parkourlrc/pcb-PionixPublic--cb-eval-board-5fd87b56d0/cb-eval-board/production/1.2/CB-EVAL-1.2-gerber/README.txt

PCB specs:

4 Layers (from Top to bottom):

1. cb-eval-board-F: Top
2. cb-eval-board-GND: 
3. cb-eval-board-VCC
4. cb-eval-board-B: Bottom

Thickness: 1.6mm
Size: 120x108mm
Material: FR4
Copper: 35um (inner and outer layers)
Finish: chem Gold
IPC-A-600 class 2

Silkscreen: both sides
----------------------
Top: F_Silkscreen
Bottom: B_Silkscreen
Silkscreen Color: White

Solder Mask:
------------
Top: F_Mask
Bottom: B_Mask
Color: Black

- Edge Cuts are on a separate layer:
  cb-eval-board-Edge_Cuts

Minimum trace size: 0.15mm
Minimum clearance: 0.15mm
Minimal ring: 0.175mm
Via minimal hole size: 0.25mm
Via total diameter: 0.6mm
