parkourlrc/pcb-PionixPublic--cb-eval-board-5fd87b56d0/cb-eval-board/production/1.2/CB-EVAL-1.2-picknplace/cb-eval-bottomview.png

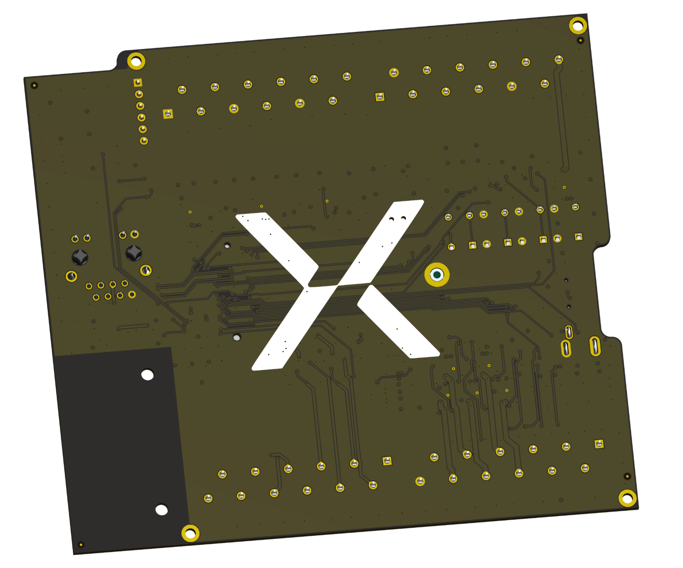
cb-eval-board/production/1.2/CB-EVAL-1.2-picknplace/cb-eval-bottomview.png
