parkourlrc/pcb-PionixPublic--cb-eval-board-5fd87b56d0/cb-eval-board/bom-devkit.csv

Reference | Value | Footprint | Qty | DNP | Manufacturer | MPN | Mouser | Digikey
C1,C2,C3,C9,C11,C12,C13,C14,C15,C21,C25,C26,C30,C31,C34,C36,C37,C39,C42,C45 | 100n | Capacitor_SMD:C_0603_1608Metric | 20 |  | Kemet | C0603C104K5RACAUTO |  | 399-6856-1-ND
C4,C7,C22,C23,C32,C43,C44 | 1u | Capacitor_SMD:C_0603_1608Metric | 7 |  | Kemet | C0603C105K3PACTU |  | 399-C0603C105K3PACTUCT-ND
C5,C6 | 4.7u 50V | Capacitor_SMD:C_1210_3225Metric | 2 |  | TDK Corporation | C3225X7R1H475K250AB |  | 445-7726-1-ND
C8 | 10u | Capacitor_SMD:C_0603_1608Metric | 1 |  | Murata Electronics | GRM188R6YA106MA73J |  | 490-GRM188R6YA106MA73JCT-ND
C10 | 100u 6.3V | Capacitor_SMD:C_1206_3216Metric | 1 |  | Taiyo Yuden | JMK316ABJ107ML-T |  | 587-3395-1-ND
C20,C24,C27,C33,C35,C40,C41 | 1n | Capacitor_SMD:C_0603_1608Metric | 7 |  | Kemet | C0603C102K5RACTU |  | 399-C0603C102K5RACTUCT-ND
C28,C29 | 100p | Capacitor_SMD:C_0603_1608Metric | 2 |  | Walsin Technology Corporation | 0603N101J500CT |  | 1292-1644-1-ND
D1,D4,D5,D6,D11,D12,D17,D18,D19,D21,D23,D25,D27,D29,D31,D33,D35,D37,D39 | LED YELLOW | LED_SMD:LED_0603_1608Metric | 19 |  | Würth Elektronik | 150060AS75000 |  | 732-150060AS75000CT-ND
D8 | CLV1L-FKB | cb-eval-lib:LED_Cree-PLCC4_3.2x2.8mm_CCW | 1 |  | Cree LED | CLV1L-FKB-CJQRNQEFGBB79353 |  | 90-CLV1L-FKB-CJQRNQEFGBB79353CT-ND
D9,D10 | MM3Z3V3ST1G | Diode_SMD:D_SOD-323 | 2 |  | onsemi | MM3Z3V3ST1G |  | MM3Z3V3ST1GOSCT-ND
D20,D22,D24,D26,D28,D30,D32,D34,D36,D38 | MM3Z5V1ST1G | Diode_SMD:D_SOD-323 | 10 |  | onsemi | MM3Z5V1ST1G |  | MM3Z5V1ST1GOSCT-ND
D41 | 5Vdc | cb-eval-lib:WE-TVS_SOT143-4L | 1 |  | Eaton - Electronics Division | STS142050UL08 |  | 283-STS142050UL08CT-ND
FB1,FB2,FB3 | 1.8k@100MHz | Inductor_SMD:L_0603_1608Metric | 3 |  | Wurth Elektronik | 742792692 |  | 732-4671-1-ND
H7 | Standoff_M.2 | cb-eval-lib:9774067243R | 1 |  | Würth Elektronik | 9774067243R
J1,J6 | Conn_01x01 | cb-eval-lib:2060451998404 | 2 |  | Wago | 2060-451/998-404 |  | 2946-2060-451/998-404CT-ND
J2 | Conn_01x06 | Connector_PinHeader_2.54mm:PinHeader_1x06_P2.54mm_Vertical | 1 |  | Samtec Inc. | TS-106-T-A |  | SAM1112-06-ND
J3 | I3C | Connector_PinHeader_2.54mm:PinHeader_1x02_P2.54mm_Vertical | 1 | Nicht bestücken | NONE | DNP
J4,J5,J7,J11 | TBL002A-350-12GY-2GY | cb-eval-lib:CUI_TBL002A-350-12GY-2GY | 4 |  | Same Sky (Formerly CUI Devices) | TBL002A-350-12GY-2GY |  | 102-6375-ND
J9 | USB_C_Receptacle_USB2.0_14P | cb-eval-lib:USB_C_Receptacle_GCT_USB4110 | 1 |  | GCT | USB4110-GF-A |  | 2073-USB4110-GF-A-1-ND
J10 | Barrel_Jack_Switch | cb-eval-lib:CUI_PJ-044AH | 1 |  | Same Sky (Formerly CUI Devices) | PJ-044AH |  | CP-044AH-ND
R1,R2,R3,R7,R13,R15,R17,R18,R19,R20,R21,R22,R23,R24,R27,R28,R31,R36,R37,R38,R39,R41,R42,R44,R45,R47,R48,R50,R51,R53,R54,R57,R59,R61,R75,R77 | 470 | Resistor_SMD:R_0603_1608Metric | 36 |  | Stackpole Electronics Inc | RMCF0603FT470R |  | RMCF0603FT470RCT-ND
R4,R5,R6,R10,R11,R69,R79,R80,R81,R82 | 330 | Resistor_SMD:R_0603_1608Metric | 10 |  | Stackpole Electronics Inc | RMCF0603FT330R |  | RMCF0603FT330RCT-ND
R8,R9,R25,R66,R88,R93,R105,R107,R109,R111,R113,R115,R117,R119 | 100k | Resistor_SMD:R_0603_1608Metric | 14 |  | Stackpole Electronics Inc | RMCF0603FT100K |  | RMCF0603FT100KCT-ND
R12 | 68 | Resistor_SMD:R_0603_1608Metric | 1 |  | Stackpole Electronics Inc | RMCF0603FT68R0 |  | RMCF0603FT68R0CT-ND
R14,R16 | 120 | Resistor_SMD:R_0603_1608Metric | 2 |  | Stackpole Electronics Inc | RMCF0603FT120R |  | RMCF0603FT120RCT-ND
R26,R33 | 5.6k | Resistor_SMD:R_0603_1608Metric | 2 |  | Stackpole Electronics Inc | RMCF0603FT5K60 |  | RMCF0603FT5K60CT-ND
R29,R83 | 6M 0.5% | Resistor_SMD:R_1206_3216Metric | 2 |  | Vishay Techno | CRMA1206AF6M00DKEF |  | 3579-CRMA1206AF6M00DKEFCT-ND
R30 | 20k 0.1% | Resistor_SMD:R_0603_1608Metric | 1 |  | Panasonic Electronic Components | ERA-3AEB203V |  | P20KDBCT-ND
R32 | 10k | Resistor_SMD:R_0603_1608Metric | 1 |  | Stackpole Electronics Inc | RMCF0603FT10K0 |  | RMCF0603FT10K0CT-ND
R34 | 402k | Resistor_SMD:R_0603_1608Metric | 1 |  | Stackpole Electronics Inc | RMCF0603FT402K
R35 | 137k | Resistor_SMD:R_0603_1608Metric | 1 |  | Stackpole Electronics Inc | RMCF0603FT137k
R40,R43,R46,R49,R52,R55,R68,R71,R74,R99 | 20k | Resistor_SMD:R_0603_1608Metric | 10 |  | Stackpole Electronics Inc | RMCF0603FT20K0 |  | RMCF0603FT20K0CT-ND
R56,R58,R60,R62,R64,R65,R67,R104,R106,R108,R110,R112,R114,R116,R118 | 1k | Resistor_SMD:R_0603_1608Metric | 15 |  | Stackpole Electronics Inc | RMCF0603FG1K00 |  | RMCF0603FG1K00CT-ND
R63 | 50m | Resistor_SMD:R_1206_3216Metric | 1 |  | Stackpole Electronics Inc | CSR1206FT50L0 |  | CSR1206FT50L0CT-ND
R70,R72,R84,R86,R89,R91 | 4.99k 0.1% | Resistor_SMD:R_0603_1608Metric | 6 |  | Panasonic Electronic Components | ERA-3AEB4991V |  | P4.99KDBCT-ND
R73,R76,R78,R94,R95,R96,R97,R98,R102,R103 | 1M | Resistor_SMD:R_0603_1608Metric | 10 |  | Stackpole Electronics Inc | RMCF0603FT1M00 |  | RMCF0603FT1M00CT-ND
R85,R90 | 825 0.1% | Resistor_SMD:R_0603_1608Metric | 2 |  | Panasonic Electronic Components | ERA-3AEB8250V |  | P909DBCT-ND
R87,R92 | 3.44k 0.1% | Resistor_SMD:R_0603_1608Metric | 2 |  | Panasonic Electronic Components | RN73R1JTTD3441B25 |  | P8.2KDBCT-ND
R100,R101 | 5.1k | Resistor_SMD:R_0603_1608Metric | 2 |  | Stackpole Electronics Inc | RMCF0603FT5K10 |  | RMCF0603FT5K10CT-ND
R120 | 0 | Resistor_SMD:R_0603_1608Metric | 1 |  | Stackpole Electronics Inc | RMCF0603ZT0R00 |  | RMCF0603ZT0R00CT-ND
SW1,SW2,SW3,SW4 | SW_Push | cb-eval-lib:SW_TS02-66-70-BK-160-LCR-D | 4 |  | Same Sky (Formerly CUI Devices) | TS02-66-70-BK-160-LCR-D |  | 2223-TS02-66-70-BK-160-LCR-D-ND
T1 | 74990101241 | cb-eval-lib:74990101241 | 1 |  | Wurth Elektronik | 74990101241 |  | 732-10834-ND
U1 | 10128796-001RLF | cb-eval-lib:AMPHENOL_10128796-001RLF_ChargeBridge_Wurth_standoff | 1 |  | Amphenol ICC (FCI) | 10128796-001RLF
U2,U3,U4,U25,U26,U27,U28,U29,U30,U31,U32,U33,U34 | 74LVC1G17 | Package_TO_SOT_SMD:SOT-353_SC-70-5 | 13 |  | Texas Instruments | SN74LVC1G17DCKR |  | 296-11934-1-ND
U5 | TMP100 | Package_TO_SOT_SMD:SOT-23-6 | 1 |  | Texas Instruments | TMP100NA/3K |  | 296-26833-1-ND
U6 | AMC3311DWER | cb-eval-lib:SOIC16_7P5X10P3_TEX | 1 |  | Texas Instruments | AMC3311DWER |  | 296-AMC3311DWERCT-ND
U9,U11,U22,U23 | INA333AIDGKR | cb-eval-lib:VSSOP-8_3x3mm_P0.65mm | 4 |  | Texas Instruments | INA333AIDGKR |  | 296-23564-1-ND
U10,U24 | REF35205QDBVR | Package_TO_SOT_SMD:SOT-23-6 | 2 |  | Texas Instruments | REF35205QDBVR |  | 296-REF35205QDBVRCT-ND
U13,U14,U15,U16,U17,U18,U19,U20,U21 | TPS27S100ARRKR | cb-eval-lib:WQFN16_RRK_TEX | 9 |  | Texas Instruments | TPS27S100ARRKR |  | 296-TPS27S100ARRKRCT-ND
U37 | 171023801 | cb-eval-lib:WPME-VDLM_LGA-12EP | 1 |  | Würth Elektronik | 171023801 |  | 732-171023801CT-ND
