parkourlrc/pcb-PionixPublic--cb-eval-board-5fd87b56d0/cb-eval-board/production/1.2/CB-EVAL-1.2-picknplace/cb-eval-board-F_Fab.pdf

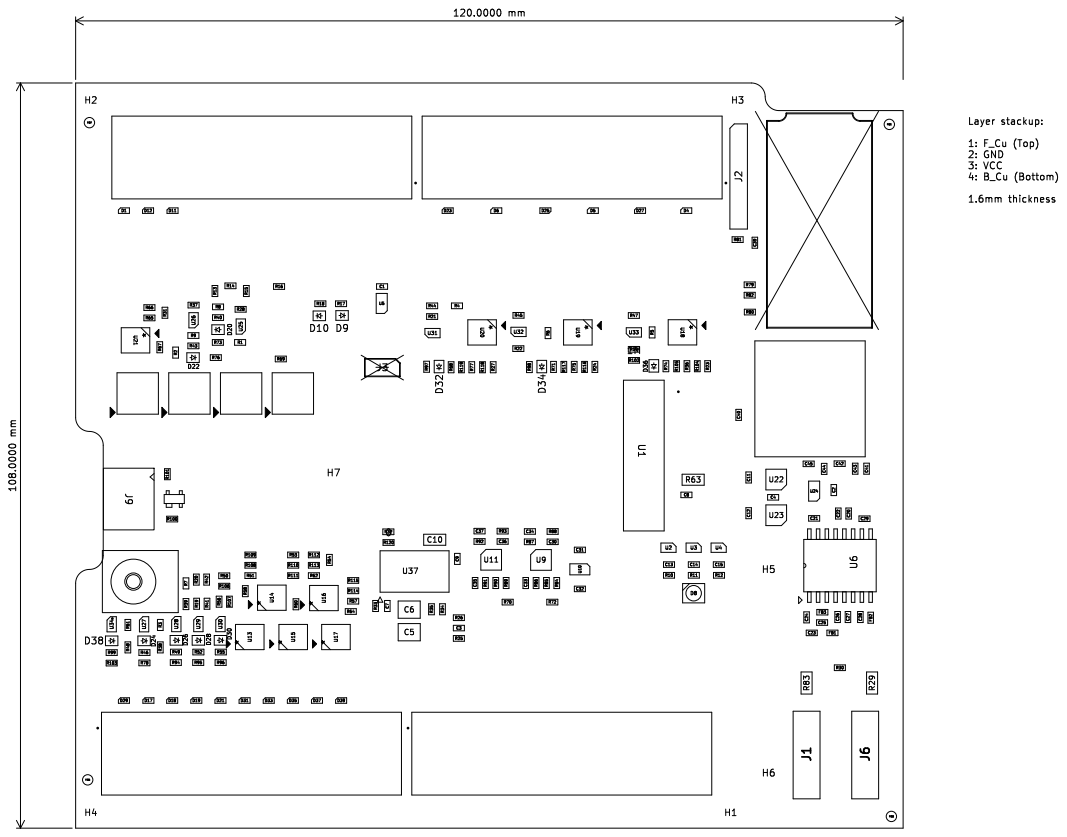
[picture p4: page 1]

Layer stackup: 1: F_Cu (Top) 2: GND
