parkourlrc/pcb-PionixPublic--cb-eval-board-5fd87b56d0/cb-eval-board/cb-eval-board.kicad_pcb

## KiCad design cb-eval-board/cb-eval-board.kicad_pcb (2025-12-01)

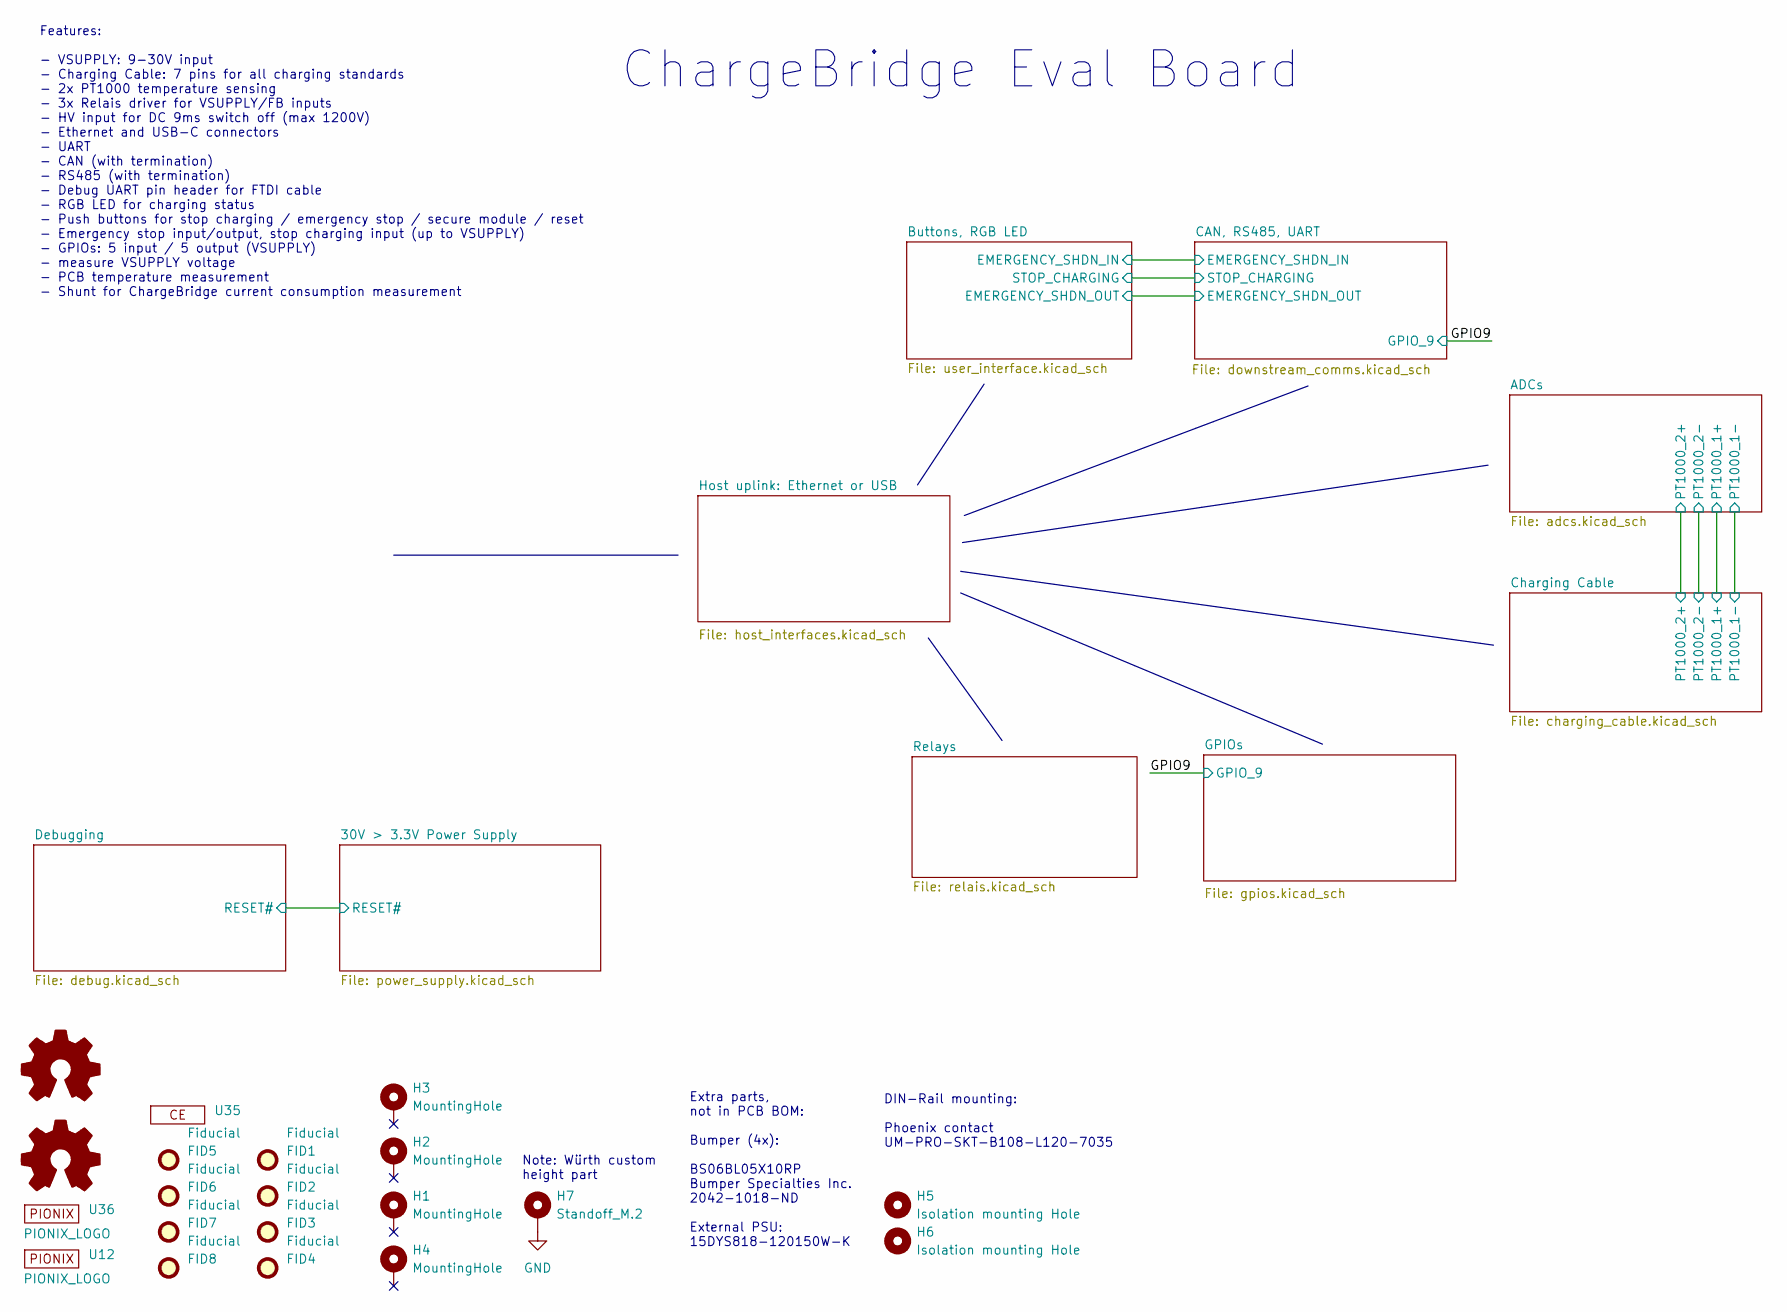
[picture p6: schematic cb-eval-board.kicad_sch, ChargeBridge Eval Board]

Parts:
FID1, FID2, FID3, FID4, FID5, FID6, FID7, FID8: Fiducial; Fiducial_0.5mm_Mask1.5mm; MPN DNP
H1, H2, H3, H4: MountingHole; MountingHole_2.2mm_M2_DIN965_Pad; MPN DNP
H5, H6: Isolation mounting Hole; MountingHole_2.7mm_M2.5_ISO14580; MPN DNP
H7: Standoff_M.2; 9774067243R; MPN 9774067243R
SYM1: Logo_Open_Hardware_Small; Symbol_Barrel_Polarity
SYM2: Logo_Open_Hardware_Small; OSHW-Symbol_6.7x6mm_SilkScreen
U12: PIONIX_LOGO; pionix-logo-2_5mm-new; MPN LOGO
U35: CE-Logo_8.5x6mm_SilkScreen
U36: PIONIX_LOGO; pionix-logo-mark; MPN LOGO

Connections:
GND: H7.1; also elsewhere on the board

Notes on the sheet:
Note: Würth custom height part
ChargeBridge Eval Board
DIN-Rail mounting: Phoenix contact UM-PRO-SKT-B108-L120-7035
Extra parts, not in PCB BOM: Bumper (4x): BS06BL05X10RP Bumper Specialties Inc. 2042-1018-ND External PSU: 15DYS818-120150W-K
Features: - VSUPPLY: 9-30V input - Charging Cable: 7 pins for all charging standards - 2x PT1000 temperature sensing - 3x Relais driver for VSUPPLY/FB inputs - HV input for DC 9ms switch off (max 1200V) - Ethernet and USB-C connectors - UART - CAN (with termination) - RS485 (with termination) - Deb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

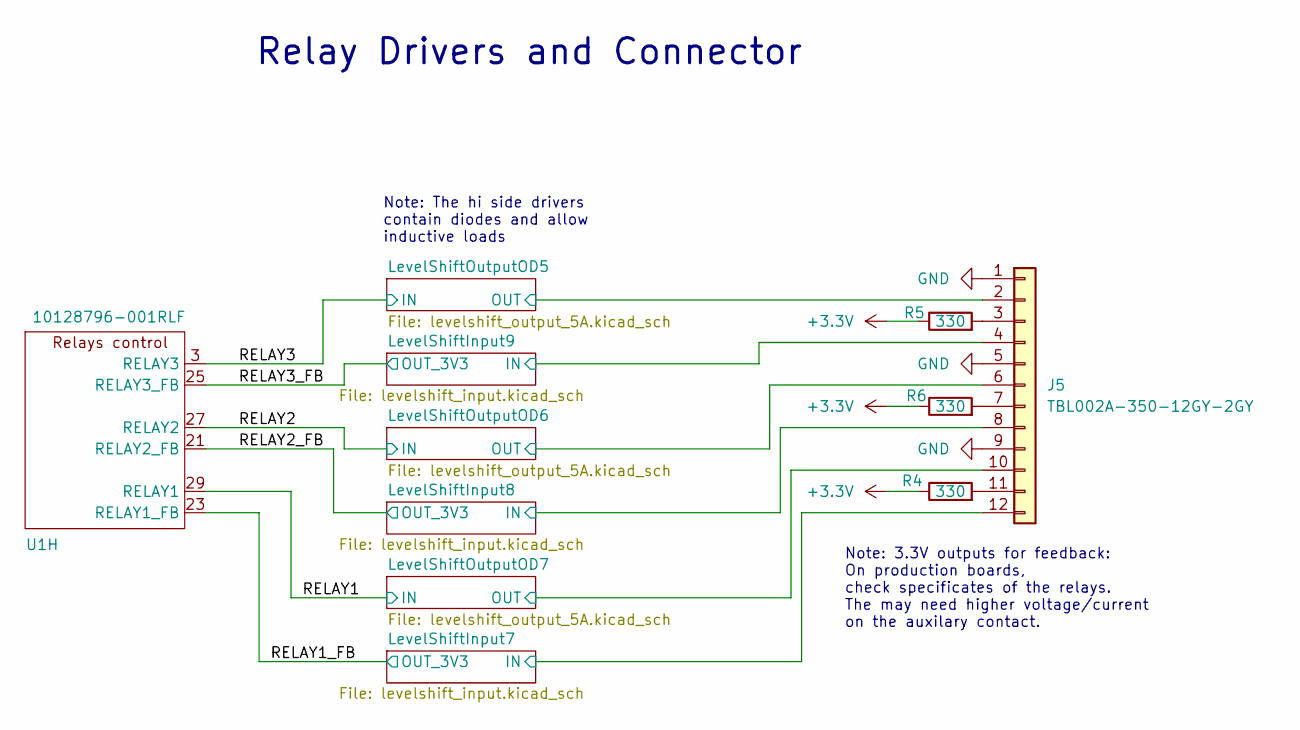
[picture p7: schematic relais.kicad_sch, ChargeBridge Eval Board]

Parts:
J5: TBL002A-350-12GY-2GY; CUI_TBL002A-350-12GY-2GY; MPN TBL002A-350-12GY-2GY; Digikey 102-6375-ND
R4, R5, R6: 330; R_0603_1608Metric; MPN RMCF0603FT330R; Digikey RMCF0603FT330RCT-ND
U1: 10128796-001RLF; AMPHENOL_10128796-001RLF_ChargeBridge_Wurth_standoff; MPN 10128796-001RLF

Connections:
+3.3V: R4.1, R5.1, R6.1; also elsewhere on the board
/Relays/LevelShiftInput7/IN: J5.12; also elsewhere on the board
/Relays/LevelShiftInput8/IN: J5.8; also elsewhere on the board
/Relays/LevelShiftInput9/IN: J5.4; also elsewhere on the board
/Relays/LevelShiftOutputOD5/OUT: J5.2; also elsewhere on the board
/Relays/LevelShiftOutputOD6/OUT: J5.6; also elsewhere on the board
/Relays/LevelShiftOutputOD7/OUT: J5.10; also elsewhere on the board
/Relays/RELAY1: U1.29 (RELAY1); also elsewhere on the board
/Relays/RELAY1_FB: U1.23 (RELAY1_FB); also elsewhere on the board
/Relays/RELAY2: U1.27 (RELAY2); also elsewhere on the board
/Relays/RELAY2_FB: U1.21 (RELAY2_FB); also elsewhere on the board
/Relays/RELAY3: U1.3 (RELAY3); also elsewhere on the board
/Relays/RELAY3_FB: U1.25 (RELAY3_FB); also elsewhere on the board
GND: J5.1, J5.5, J5.9; also elsewhere on the board
unnamed: J5.3, R5.2
unnamed: J5.7, R6.2
unnamed: J5.11, R4.2

Notes on the sheet:
Relay Drivers and Connector
Note: 3.3V outputs for feedback: On production boards, check specificates of the relays. The may need higher voltage/current on the auxilary contact.
Note: The hi side drivers contain diodes and allow inductive loads

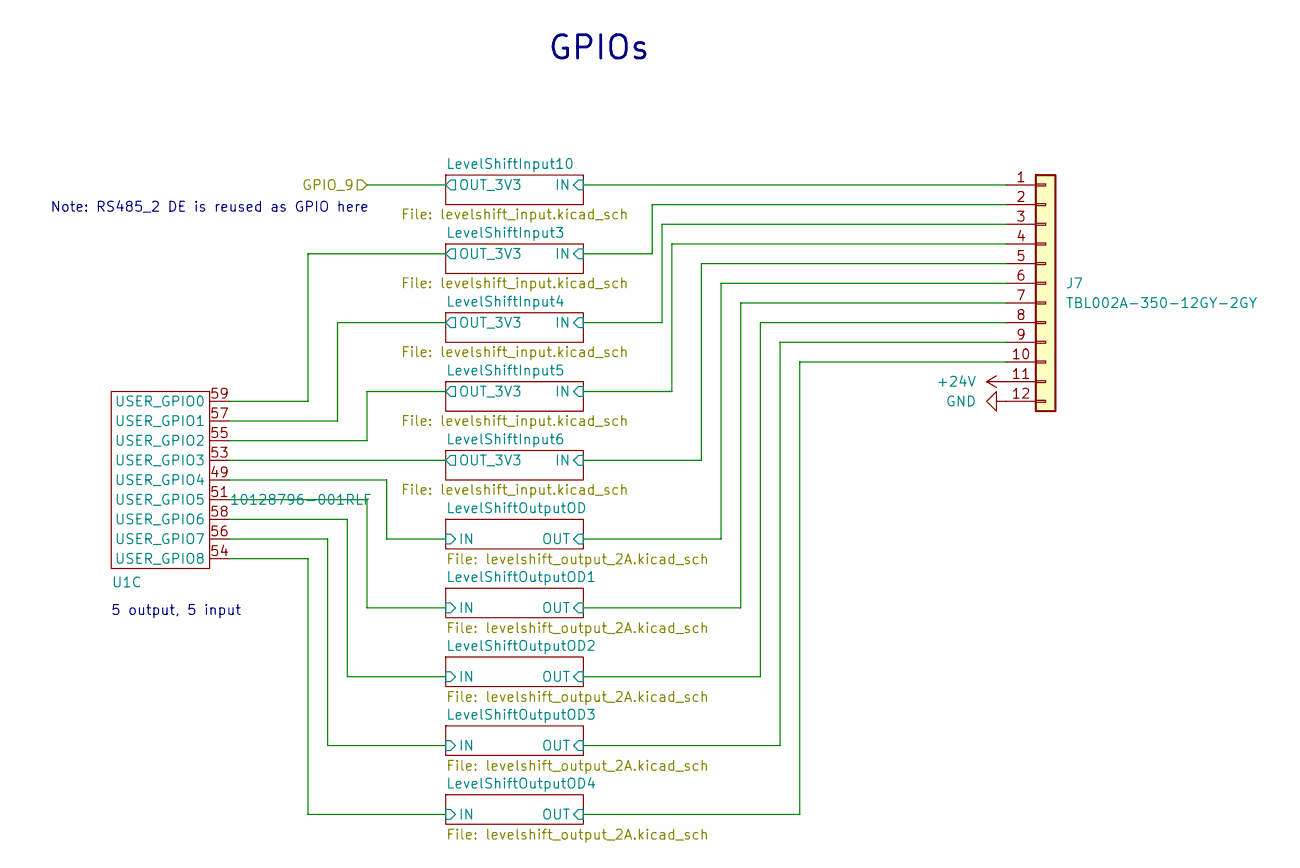
[picture p8: schematic gpios.kicad_sch, ChargeBridge Eval Board]

Parts:
J7: TBL002A-350-12GY-2GY; CUI_TBL002A-350-12GY-2GY; MPN TBL002A-350-12GY-2GY; Digikey 102-6375-ND
U1: 10128796-001RLF; AMPHENOL_10128796-001RLF_ChargeBridge_Wurth_standoff; MPN 10128796-001RLF

Connections:
+24V: J7.11; also elsewhere on the board
/GPIOs/LevelShiftInput3/IN: J7.2; also elsewhere on the board
/GPIOs/LevelShiftInput3/OUT_3V3: U1.59 (USER_GPIO0); also elsewhere on the board
/GPIOs/LevelShiftInput4/IN: J7.3; also elsewhere on the board
/GPIOs/LevelShiftInput4/OUT_3V3: U1.57 (USER_GPIO1); also elsewhere on the board
/GPIOs/LevelShiftInput5/IN: J7.4; also elsewhere on the board
/GPIOs/LevelShiftInput5/OUT_3V3: U1.55 (USER_GPIO2); also elsewhere on the board
/GPIOs/LevelShiftInput6/IN: J7.5; also elsewhere on the board
/GPIOs/LevelShiftInput6/OUT_3V3: U1.53 (USER_GPIO3); also elsewhere on the board
/GPIOs/LevelShiftInput10/IN: J7.1; also elsewhere on the board
/GPIOs/LevelShiftOutputOD1/IN: U1.51 (USER_GPIO5); also elsewhere on the board
/GPIOs/LevelShiftOutputOD1/OUT: J7.7; also elsewhere on the board
/GPIOs/LevelShiftOutputOD2/IN: U1.58 (USER_GPIO6); also elsewhere on the board
/GPIOs/LevelShiftOutputOD2/OUT: J7.8; also elsewhere on the board
/GPIOs/LevelShiftOutputOD3/IN: U1.56 (USER_GPIO7); also elsewhere on the board
/GPIOs/LevelShiftOutputOD3/OUT: J7.9; also elsewhere on the board
/GPIOs/LevelShiftOutputOD4/IN: U1.54 (USER_GPIO8); also elsewhere on the board
/GPIOs/LevelShiftOutputOD4/OUT: J7.10; also elsewhere on the board
/GPIOs/LevelShiftOutputOD/IN: U1.49 (USER_GPIO4); also elsewhere on the board
/GPIOs/LevelShiftOutputOD/OUT: J7.6; also elsewhere on the board
GND: J7.12; also elsewhere on the board

Notes on the sheet:
5 output, 5 input
GPIOs
Note: RS485_2 DE is reused as GPIO here

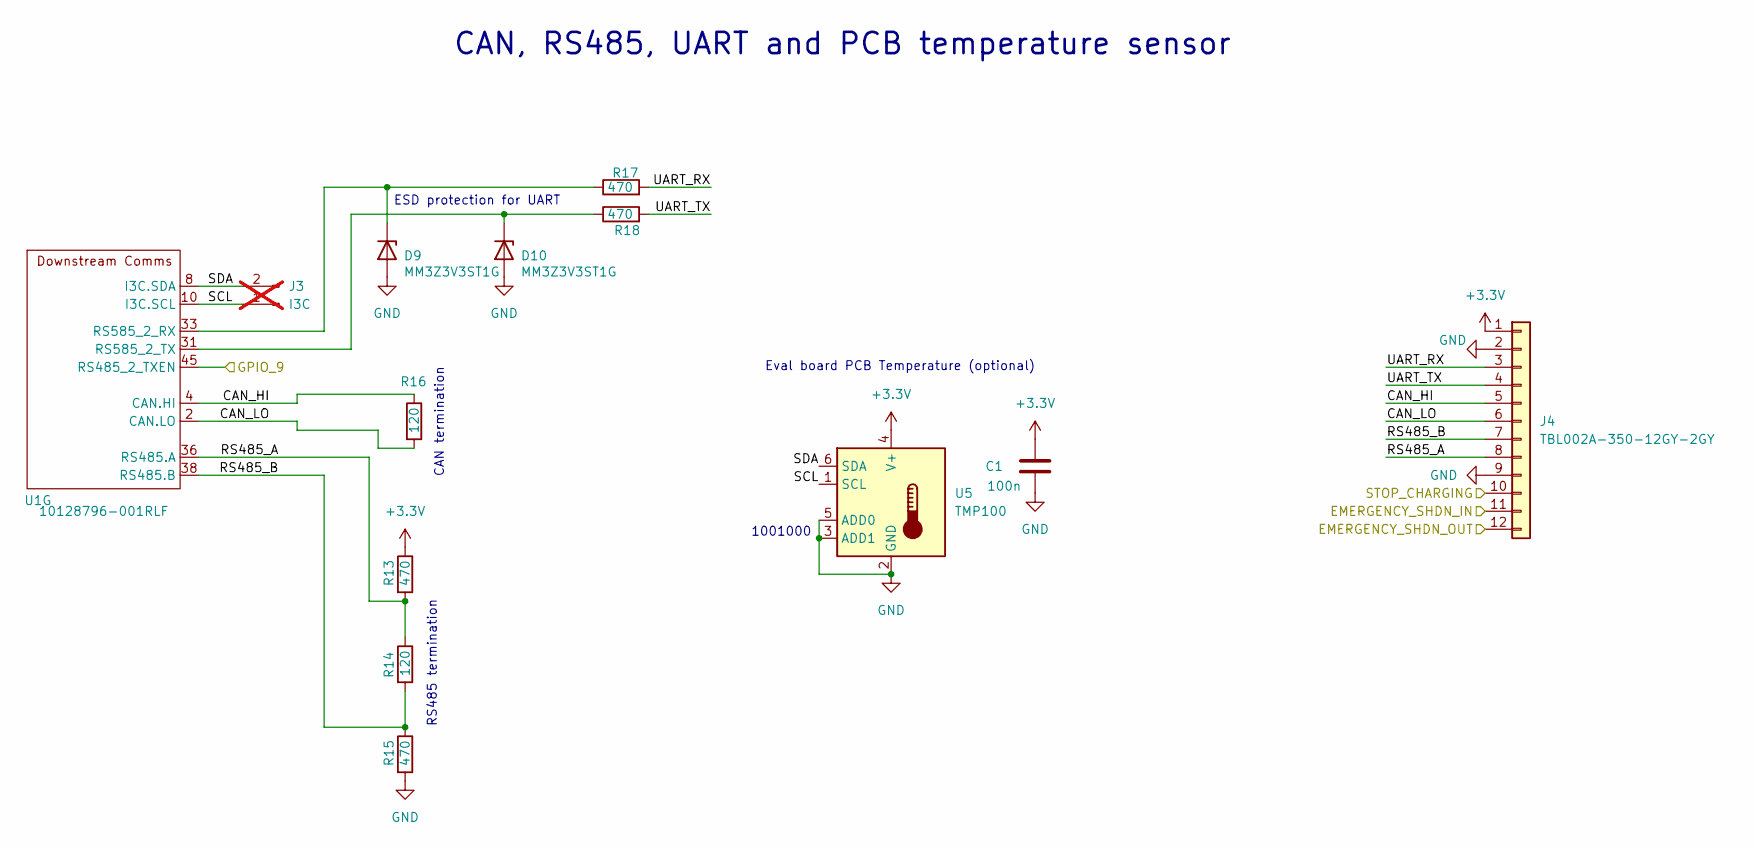
[picture p9: schematic downstream_comms.kicad_sch, ChargeBridge Eval Board]

Parts:
C1: 100n; C_0603_1608Metric; MPN C0603C104K5RACAUTO; Digikey 399-6856-1-ND
D9, D10: MM3Z3V3ST1G; D_SOD-323; MPN MM3Z3V3ST1G; Digikey MM3Z3V3ST1GOSCT-ND
J3: I3C; PinHeader_1x02_P2.54mm_Vertical; MPN DNP; not fitted
J4: TBL002A-350-12GY-2GY; CUI_TBL002A-350-12GY-2GY; MPN TBL002A-350-12GY-2GY; Digikey 102-6375-ND
R13, R15, R17, R18: 470; R_0603_1608Metric; MPN RMCF0603FT470R; Digikey RMCF0603FT470RCT-ND
R14, R16: 120; R_0603_1608Metric; MPN RMCF0603FT120R; Digikey RMCF0603FT120RCT-ND
U1: 10128796-001RLF; AMPHENOL_10128796-001RLF_ChargeBridge_Wurth_standoff; MPN 10128796-001RLF
U5: TMP100; SOT-23-6; MPN TMP100NA/3K; Digikey 296-26833-1-ND

Connections:
+3.3V: C1.1, J4.1, R13.1, U5.4 (V+); also elsewhere on the board
/Buttons, RGB LED/EMERGENCY_SHDN_IN: J4.11; also elsewhere on the board
/Buttons, RGB LED/EMERGENCY_SHDN_OUT: J4.12; also elsewhere on the board
/Buttons, RGB LED/STOP_CHARGING: J4.10; also elsewhere on the board
/CAN, RS485, UART/CAN_HI: J4.5, R16.1, U1.4 (CAN.HI)
/CAN, RS485, UART/CAN_LO: J4.6, R16.2, U1.2 (CAN.LO)
/CAN, RS485, UART/RS485_A: J4.8, R13.2, R14.1, U1.36 (RS485.A)
/CAN, RS485, UART/RS485_B: J4.7, R14.2, R15.1, U1.38 (RS485.B)
/CAN, RS485, UART/SCL: J3.1, U1.10 (I3C.SCL), U5.1 (SCL)
/CAN, RS485, UART/SDA: J3.2, U1.8 (I3C.SDA), U5.6 (SDA)
/CAN, RS485, UART/UART_RX: J4.3, R17.2
/CAN, RS485, UART/UART_TX: J4.4, R18.2
/GPIO9: U1.45 (RS485_2_TXEN); also elsewhere on the board
GND: C1.2, D9.2 (A), D10.2 (A), J4.2, J4.9, R15.2, U5.2 (GND), U5.3 (ADD1), U5.5 (ADD0); also elsewhere on the board
unnamed: D9.1 (K), R17.1, U1.33 (RS585_2_RX)
unnamed: D10.1 (K), R18.1, U1.31 (RS585_2_TX)

Notes on the sheet:
Eval board PCB Temperature (optional)
1001000
ESD protection for UART
CAN termination
RS485 termination
CAN, RS485, UART and PCB temperature sensor

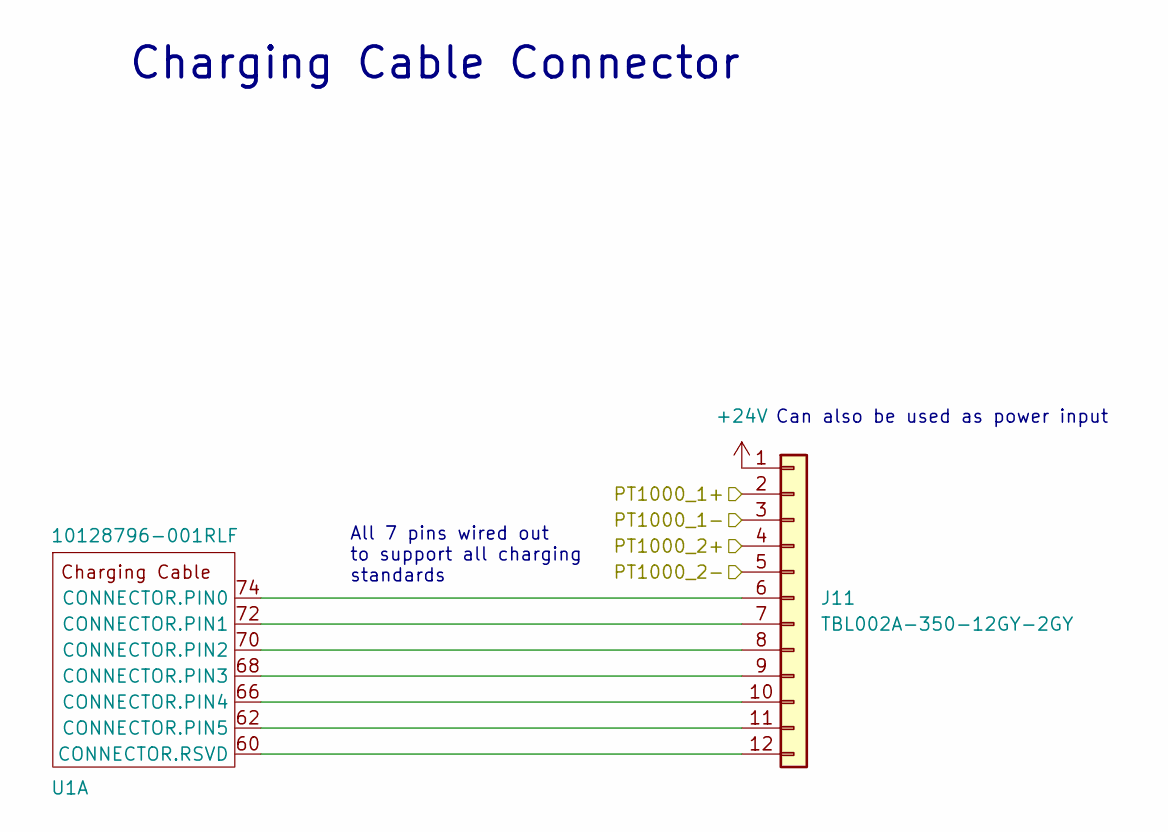
[picture p10: schematic charging_cable.kicad_sch, ChargeBridge Eval Board]

Parts:
J11: TBL002A-350-12GY-2GY; CUI_TBL002A-350-12GY-2GY; MPN TBL002A-350-12GY-2GY; Digikey 102-6375-ND
U1: 10128796-001RLF; AMPHENOL_10128796-001RLF_ChargeBridge_Wurth_standoff; MPN 10128796-001RLF

Connections:
+24V: J11.1; also elsewhere on the board
/ADCs/PT1000_1+: J11.2; also elsewhere on the board
/ADCs/PT1000_1-: J11.3; also elsewhere on the board
/ADCs/PT1000_2+: J11.4; also elsewhere on the board
/ADCs/PT1000_2-: J11.5; also elsewhere on the board
unnamed: J11.6, U1.74 (CONNECTOR.PIN0)
unnamed: J11.7, U1.72 (CONNECTOR.PIN1)
unnamed: J11.8, U1.70 (CONNECTOR.PIN2)
unnamed: J11.9, U1.68 (CONNECTOR.PIN3)
unnamed: J11.10, U1.66 (CONNECTOR.PIN4)
unnamed: J11.11, U1.62 (CONNECTOR.PIN5)
unnamed: J11.12, U1.60 (CONNECTOR.RSVD)

Notes on the sheet:
Charging Cable Connector
Can also be used as power input
All 7 pins wired out to support all charging standards

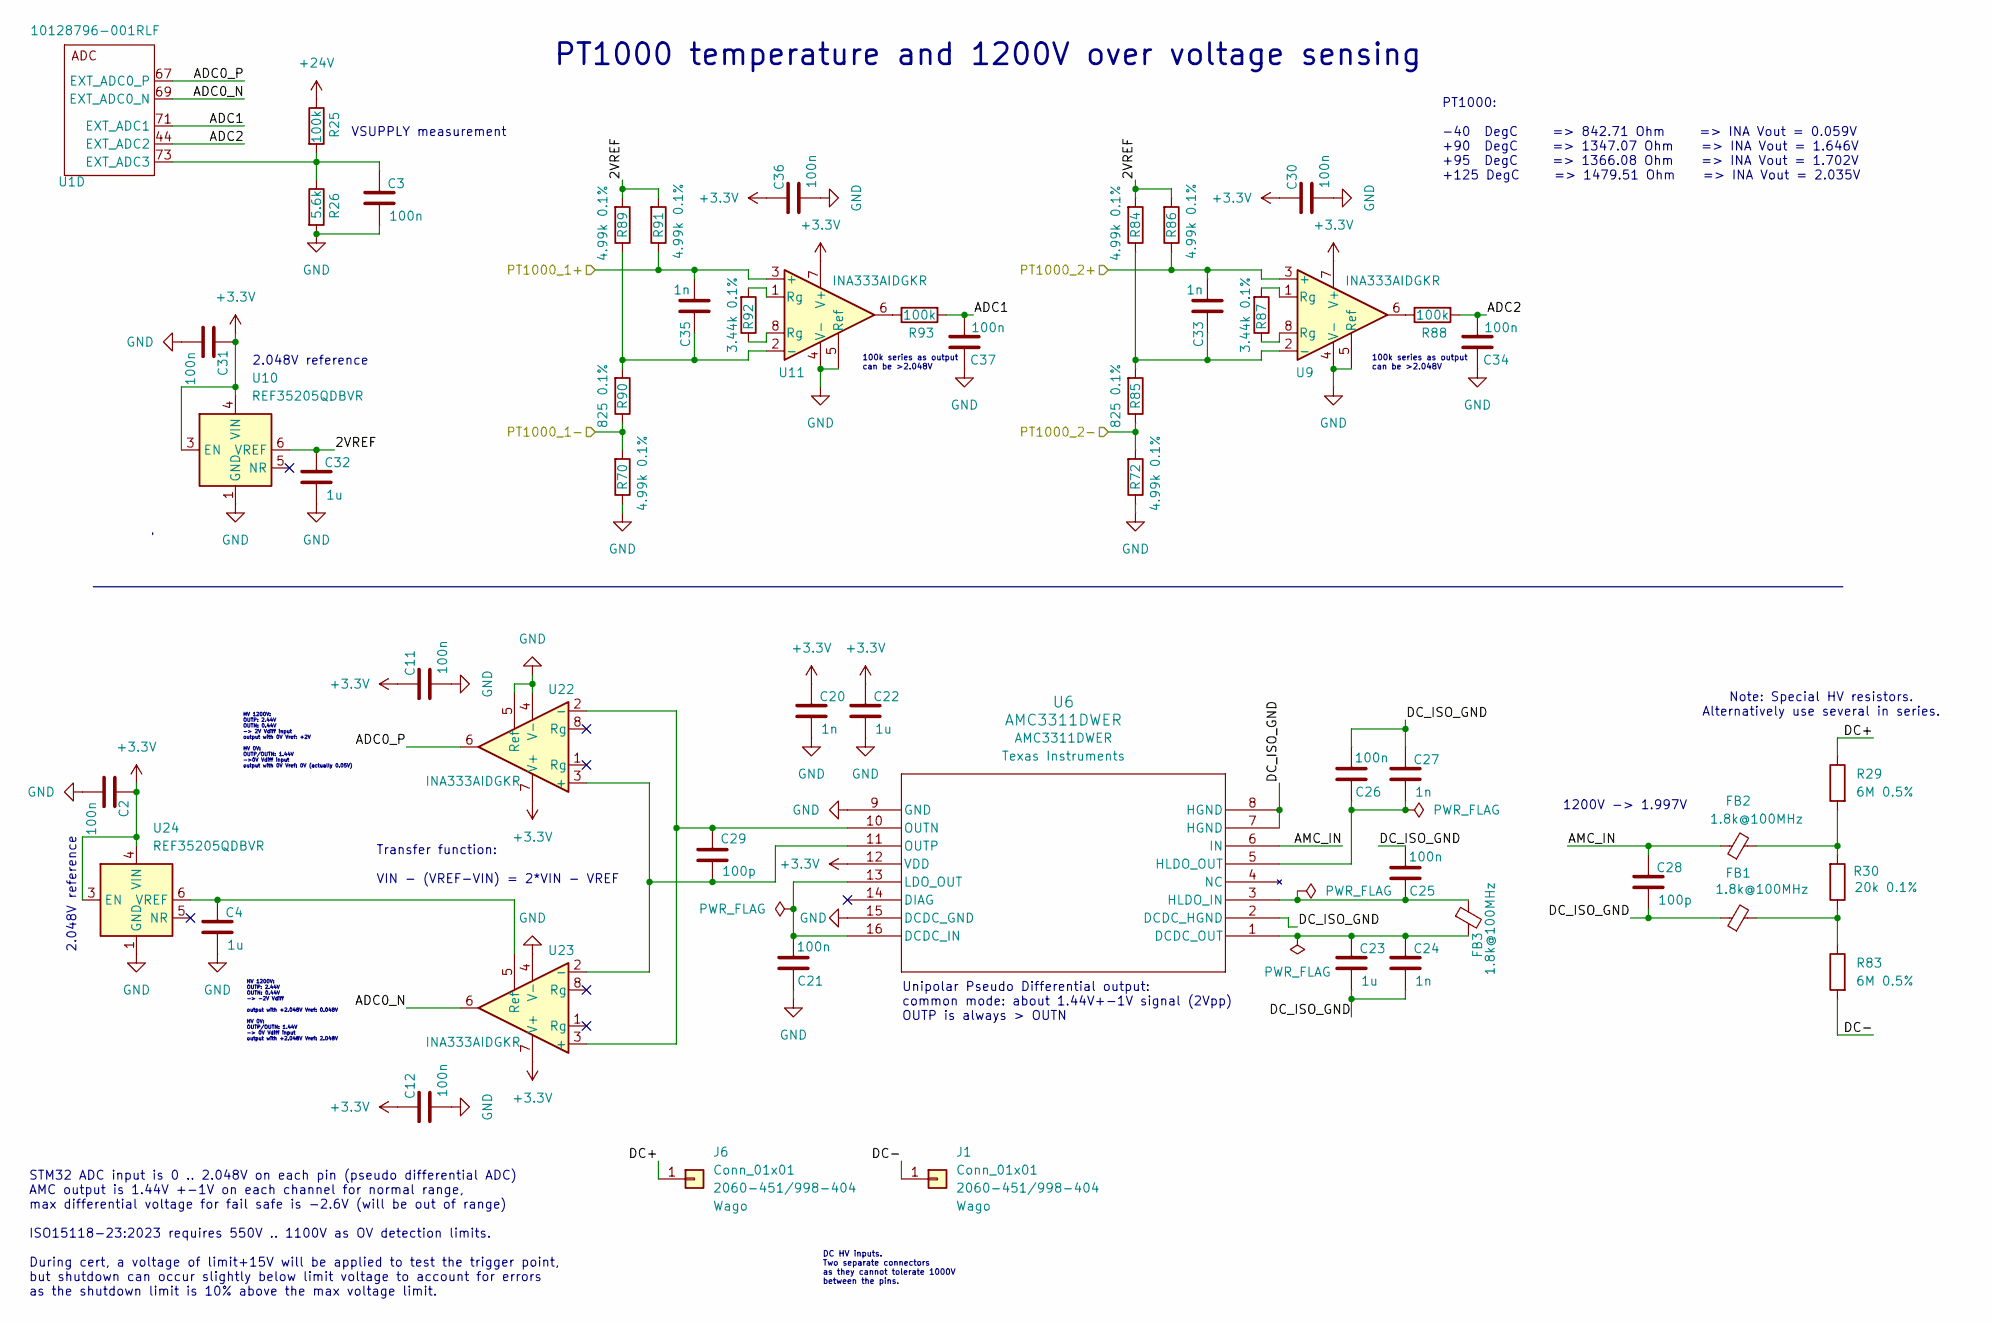
[picture p11: schematic adcs.kicad_sch, ChargeBridge Eval Board]

Parts:
C2, C3, C11, C12, C21, C25, C26, C30, C31, C34, C36, C37: 100n; C_0603_1608Metric; MPN C0603C104K5RACAUTO; Digikey 399-6856-1-ND
C4, C22, C23, C32: 1u; C_0603_1608Metric; MPN C0603C105K3PACTU; Digikey 399-C0603C105K3PACTUCT-ND
C20, C24, C27, C33, C35: 1n; C_0603_1608Metric; MPN C0603C102K5RACTU; Digikey 399-C0603C102K5RACTUCT-ND
C28, C29: 100p; C_0603_1608Metric; MPN 0603N101J500CT; Digikey 1292-1644-1-ND
FB1, FB2, FB3: 1.8k@100MHz; L_0603_1608Metric; MPN 742792692; Digikey 732-4671-1-ND
J1, J6: Conn_01x01; 2060451998404; MPN 2060-451/998-404; Digikey 2946-2060-451/998-404CT-ND
R25, R88, R93: 100k; R_0603_1608Metric; MPN RMCF0603FT100K; Digikey RMCF0603FT100KCT-ND
R26: 5.6k; R_0603_1608Metric; MPN RMCF0603FT5K60; Digikey RMCF0603FT5K60CT-ND
R29, R83: 6M 0.5%; R_1206_3216Metric; MPN CRMA1206AF6M00DKEF; JLCPCB Part# C3986300
R30: 20k 0.1%; R_0603_1608Metric; MPN ERA-3AEB203V; JLCPCB Part# C469660
R70, R72, R84, R86, R89, R91: 4.99k 0.1%; R_0603_1608Metric; MPN ERA-3AEB4991V; Digikey P4.99KDBCT-ND
R85, R90: 825 0.1%; R_0603_1608Metric; MPN ERA-3AEB8250V; Digikey P909DBCT-ND
R87, R92: 3.44k 0.1%; R_0603_1608Metric; MPN RN73R1JTTD3441B25; Digikey P8.2KDBCT-ND
U1: 10128796-001RLF; AMPHENOL_10128796-001RLF_ChargeBridge_Wurth_standoff; MPN 10128796-001RLF
U6: AMC3311DWER; SOIC16_7P5X10P3_TEX; MPN AMC3311DWER; Digikey 296-AMC3311DWERCT-ND
U9, U11, U22, U23: INA333AIDGKR; VSSOP-8_3x3mm_P0.65mm; MPN INA333AIDGKR; Digikey 296-23564-1-ND
U10, U24: REF35205QDBVR; SOT-23-6; MPN REF35205QDBVR; Digikey 296-REF35205QDBVRCT-ND

Connections:
+3.3V: C2.1, C11.1, C12.1, C20.1, C22.1, C30.1, C31.1, C36.1, U6.12 (VDD), U9.7 (V+), U10.3 (EN), U10.4 (VIN), U11.7 (V+), U22.7 (V+), U23.7 (V+), U24.3 (EN), U24.4 (VIN); also elsewhere on the board
+24V: R25.1; also elsewhere on the board
/ADCs/2VREF: C32.1, R84.2, R86.2, R89.2, R91.2, U10.6 (VREF)
/ADCs/ADC0_N: U1.69 (EXT_ADC0_N), U23.6
/ADCs/ADC0_P: U1.67 (EXT_ADC0_P), U22.6
/ADCs/ADC1: C37.2, R93.2, U1.71 (EXT_ADC1)
/ADCs/ADC2: C34.2, R88.2, U1.44 (EXT_ADC2)
/ADCs/AMC_IN: C28.1, FB2.1, U6.6 (IN)
/ADCs/DC+: J6.1, R29.1
/ADCs/DC-: J1.1, R83.2
/ADCs/DC_ISO_GND: C23.2, C24.2, C25.2, C26.2, C27.1, C28.2, FB1.1, U6.2 (DCDC_HGND), U6.7 (HGND), U6.8 (HGND)
/ADCs/PT1000_1+: C35.2, R91.1, U11.3 (+); also elsewhere on the board
/ADCs/PT1000_1-: R70.2, R90.1; also elsewhere on the board
/ADCs/PT1000_2+: C33.2, R86.1, U9.3 (+); also elsewhere on the board
/ADCs/PT1000_2-: R72.2, R85.1; also elsewhere on the board
GND: C2.2, C3.2, C4.2, C11.2, C12.2, C20.2, C21.1, C22.2, C30.2, C31.2, C32.2, C34.1, C36.2, C37.1, R26.2, R70.1, R72.1, U6.9 (GND), U6.15 (DCDC_GND), U9.4 (V-), U9.5 (Ref), U10.1 (GND), U10.2 (GND), U11.4 (V-), U11.5 (Ref), U22.4 (V-), U22.5 (Ref), U23.4 (V-), U24.1 (GND), U24.2 (GND); also elsewhere on the board
unnamed: FB1.2, R30.1, R83.1
unnamed: FB2.2, R29.2, R30.2
unnamed: R87.1, U9.8 (Rg)
unnamed: R87.2, U9.1 (Rg)
unnamed: R88.1, U9.6
unnamed: R92.1, U11.8 (Rg)
unnamed: R92.2, U11.1 (Rg)
unnamed: R93.1, U11.6
unnamed: C3.1, R25.2, R26.1, U1.73 (EXT_ADC3)
unnamed: C21.2, U6.13 (LDO_OUT), U6.16 (DCDC_IN)
unnamed: C23.1, C24.1, FB3.2, U6.1 (DCDC_OUT)
unnamed: C25.1, FB3.1, U6.3 (HLDO_IN)
unnamed: C26.1, C27.2, U6.5 (HLDO_OUT)
unnamed: C33.1, R84.1, R85.2, U9.2 (-)
unnamed: C35.1, R89.1, R90.2, U11.2 (-)
unnamed: C29.2, U6.11 (OUTP), U22.3 (+), U23.2 (-)
unnamed: C29.1, U6.10 (OUTN), U22.2 (-), U23.3 (+)
unnamed: C4.1, U23.5 (Ref), U24.6 (VREF)

Notes on the sheet:
HV 1200V: OUTP: 2.44V OUTN: 0.44V -> 2V Vdiff input output with 0V Vref: +2V HV 0V: OUTP/OUTN: 1.44V ->0V Vdiff input output with 0V Vref: 0V (actually 0.05V)
STM32 ADC input is 0 .. 2.048V on each pin (pseudo differential ADC) AMC output is 1.44V +-1V on each channel for normal range, max differential voltage for fail safe is -2.6V (will be out of range) ISO15118-23:2023 requires 550V .. 1100V as OV detection limits. During cert, a voltage of limit+15V 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
100k series as output can be >2.048V
2.048V reference
Transfer function: VIN - (VREF-VIN) = 2*VIN - VREF
DC HV inputs. Two separate connectors as they cannot tolerate 1000V between the pins.
1200V -> 1.997V
HV 1200V: OUTP: 2.44V OUTN: 0.44V -> -2V Vdiff output with +2.048V Vref: 0.048V HV 0V: OUTP/OUTN: 1.44V -> 0V Vdiff input output with +2.048V Vref: 2.048V
Note: Special HV resistors. Alternatively use several in series.
VSUPPLY measurement
PT1000 temperature and 1200V over voltage sensing
PT1000: -40 DegC => 842.71 Ohm => INA Vout = 0.059V +90 DegC => 1347.07 Ohm => INA Vout = 1.646V +95 DegC => 1366.08 Ohm => INA Vout = 1.702V +125 DegC => 1479.51 Ohm => INA Vout = 2.035V
Unipolar Pseudo Differential output: common mode: about 1.44V+-1V signal (2Vpp) OUTP is always > OUTN

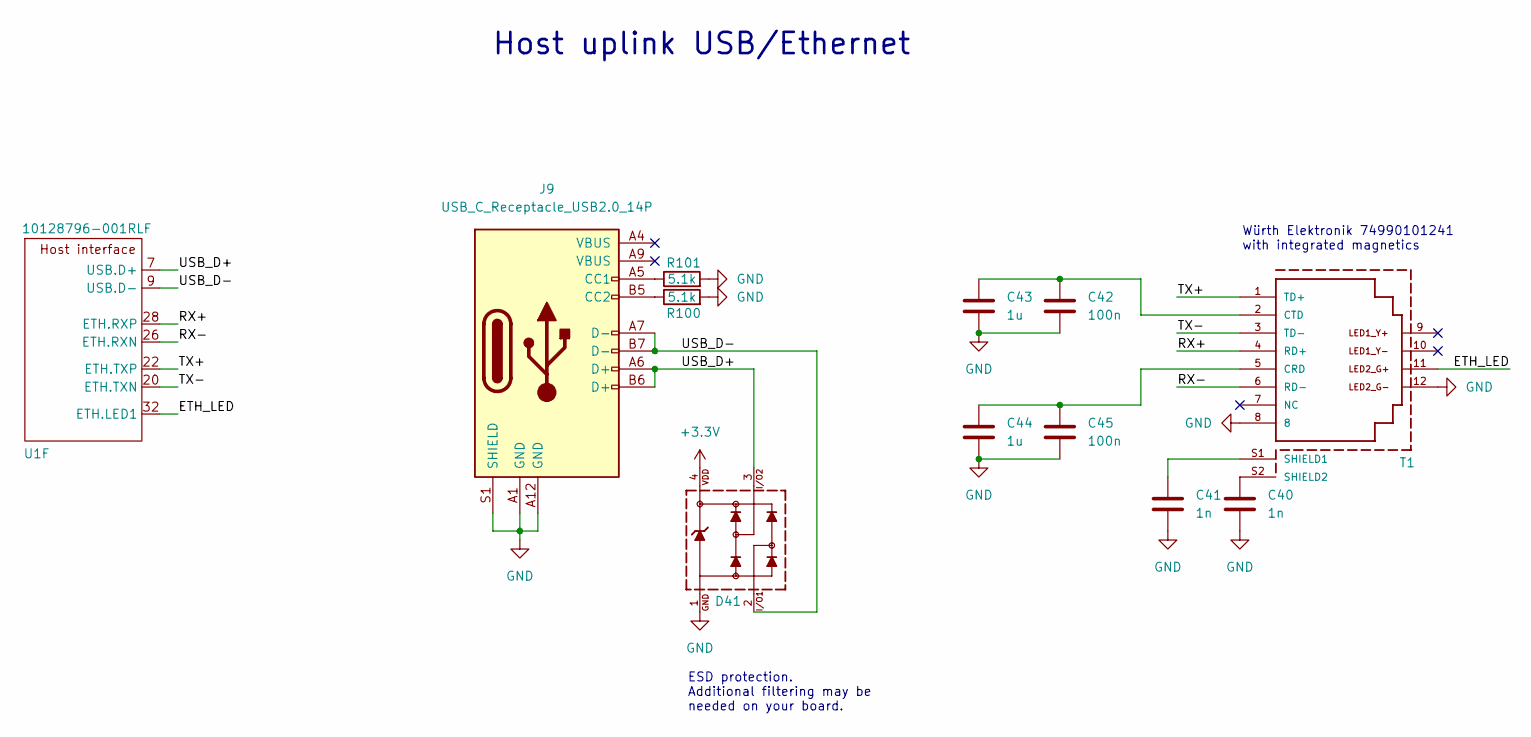
[picture p12: schematic host_interfaces.kicad_sch, ChargeBridge Eval Board]

Parts:
C40, C41: 1n; C_0603_1608Metric; MPN C0603C102K5RACTU; Digikey 399-C0603C102K5RACTUCT-ND
C42, C45: 100n; C_0603_1608Metric; MPN C0603C104K5RACAUTO; Digikey 399-6856-1-ND
C43, C44: 1u; C_0603_1608Metric; MPN C0603C105K3PACTU; Digikey 399-C0603C105K3PACTUCT-ND
D41: 5Vdc; WE-TVS_SOT143-4L; MPN STS142050UL08; Digikey 283-STS142050UL08CT-ND
J9: USB_C_Receptacle_USB2.0_14P; USB_C_Receptacle_GCT_USB4110; MPN USB4110-GF-A; Digikey 2073-USB4110-GF-A-1-ND
R100, R101: 5.1k; R_0603_1608Metric; MPN RMCF0603FT5K10; Digikey RMCF0603FT5K10CT-ND
T1: 74990101241; MPN 74990101241; Digikey 732-10834-ND
U1: 10128796-001RLF; AMPHENOL_10128796-001RLF_ChargeBridge_Wurth_standoff; MPN 10128796-001RLF

Connections:
+3.3V: D41.4; also elsewhere on the board
/Host uplink: Ethernet or USB/ETH_LED: T1.11, U1.32 (ETH.LED1)
/Host uplink: Ethernet or USB/RX+: T1.4 (RD+), U1.28 (ETH.RXP)
/Host uplink: Ethernet or USB/RX-: T1.6 (RD-), U1.26 (ETH.RXN)
/Host uplink: Ethernet or USB/TX+: T1.1 (TD+), U1.22 (ETH.TXP)
/Host uplink: Ethernet or USB/TX-: T1.3 (TD-), U1.20 (ETH.TXN)
/Host uplink: Ethernet or USB/USB_D+: D41.3, J9.A6 (D+), J9.B6 (D+), U1.7 (USB.D+)
/Host uplink: Ethernet or USB/USB_D-: D41.2, J9.A7 (D-), J9.B7 (D-), U1.9 (USB.D-)
GND: C40.2, C41.2, C42.2, C43.2, C44.2, C45.2, D41.1, J9.A1 (GND), J9.A12 (GND), J9.S1 (SHIELD), R100.2, R101.2, T1.8, T1.12; also elsewhere on the board
unnamed: J9.A5 (CC1), R101.1
unnamed: J9.B5 (CC2), R100.1
unnamed: C44.1, C45.1, T1.5 (CRD)
unnamed: C42.1, C43.1, T1.2 (CTD)
unnamed: C41.1, T1.S1 (SHIELD1)
unnamed: C40.1, T1.S2 (SHIELD2)

Notes on the sheet:
Würth Elektronik 74990101241 with integrated magnetics
Host uplink USB/Ethernet
ESD protection. Additional filtering may be needed on your board.

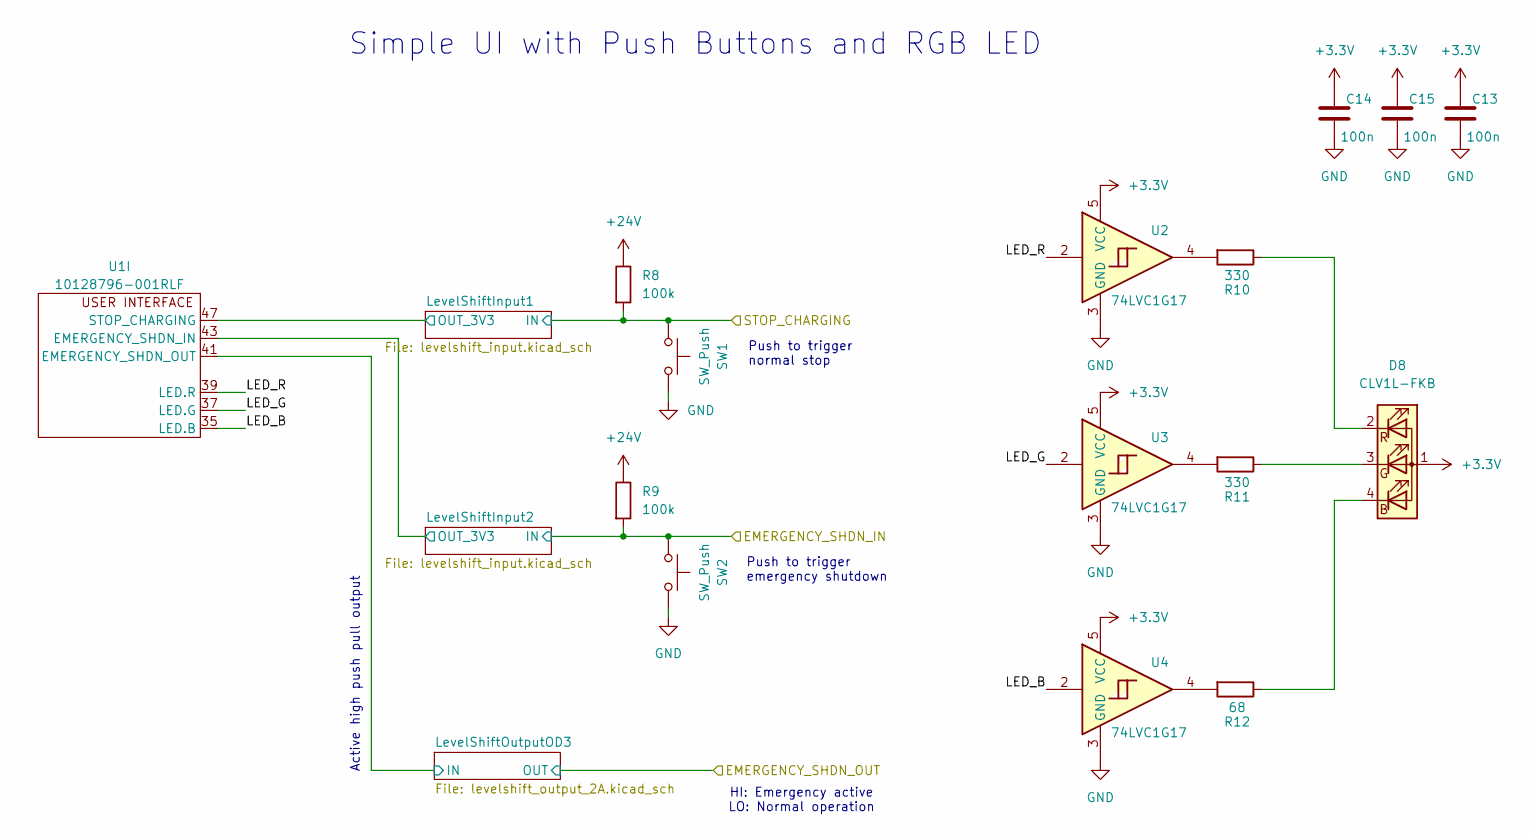
[picture p13: schematic user_interface.kicad_sch, ChargeBridge Eval Board]

Parts:
C13, C14, C15: 100n; C_0603_1608Metric; MPN C0603C104K5RACAUTO; Digikey 399-6856-1-ND
D8: CLV1L-FKB; LED_Cree-PLCC4_3.2x2.8mm_CCW; MPN CLV1L-FKB-CJQRNQEFGBB79353; Digikey 90-CLV1L-FKB-CJQRNQEFGBB79353CT-ND
R8, R9: 100k; R_0603_1608Metric; MPN RMCF0603FT100K; Digikey RMCF0603FT100KCT-ND
R10, R11: 330; R_0603_1608Metric; MPN RMCF0603FT330R; Digikey RMCF0603FT330RCT-ND
R12: 68; R_0603_1608Metric; MPN RMCF0603FT68R0; Digikey RMCF0603FT68R0CT-ND
SW1, SW2: SW_Push; SW_TS02-66-70-BK-160-LCR-D; MPN TS02-66-70-BK-160-LCR-D; Digikey 2223-TS02-66-70-BK-160-LCR-D-ND
U1: 10128796-001RLF; AMPHENOL_10128796-001RLF_ChargeBridge_Wurth_standoff; MPN 10128796-001RLF
U2, U3, U4: 74LVC1G17; SOT-353_SC-70-5; MPN SN74LVC1G17DCKR; Digikey 296-11934-1-ND

Connections:
+3.3V: C13.1, C14.1, C15.1, D8.1 (A), U2.5 (VCC), U3.5 (VCC), U4.5 (VCC); also elsewhere on the board
+24V: R8.1, R9.1; also elsewhere on the board
/Buttons, RGB LED/EMERGENCY_SHDN_IN: R9.2, SW2.1; also elsewhere on the board
/Buttons, RGB LED/LED_B: U1.35 (LED.B), U4.2
/Buttons, RGB LED/LED_G: U1.37 (LED.G), U3.2
/Buttons, RGB LED/LED_R: U1.39 (LED.R), U2.2
/Buttons, RGB LED/LevelShiftInput1/OUT_3V3: U1.47 (STOP_CHARGING); also elsewhere on the board
/Buttons, RGB LED/LevelShiftInput2/OUT_3V3: U1.43 (EMERGENCY_SHDN_IN); also elsewhere on the board
/Buttons, RGB LED/LevelShiftOutputOD3/IN: U1.41 (EMERGENCY_SHDN_OUT); also elsewhere on the board
/Buttons, RGB LED/STOP_CHARGING: R8.2, SW1.1; also elsewhere on the board
GND: C13.2, C14.2, C15.2, SW1.2, SW2.2, U2.3 (GND), U3.3 (GND), U4.3 (GND); also elsewhere on the board
unnamed: D8.4 (BK), R12.1
unnamed: D8.3 (GK), R11.1
unnamed: D8.2 (RK), R10.1
unnamed: R10.2, U2.4
unnamed: R11.2, U3.4
unnamed: R12.2, U4.4

Notes on the sheet:
Active high push pull output
HI: Emergency active LO: Normal operation
Simple UI with Push Buttons and RGB LED
Push to trigger emergency shutdown
Push to trigger normal stop
