parkourlrc/pcb-PionixPublic--cb-eval-board-5fd87b56d0/cb-eval-board/cb-eval-board.kicad_pcb

## KiCad design cb-eval-board/cb-eval-board.kicad_pcb (continued)

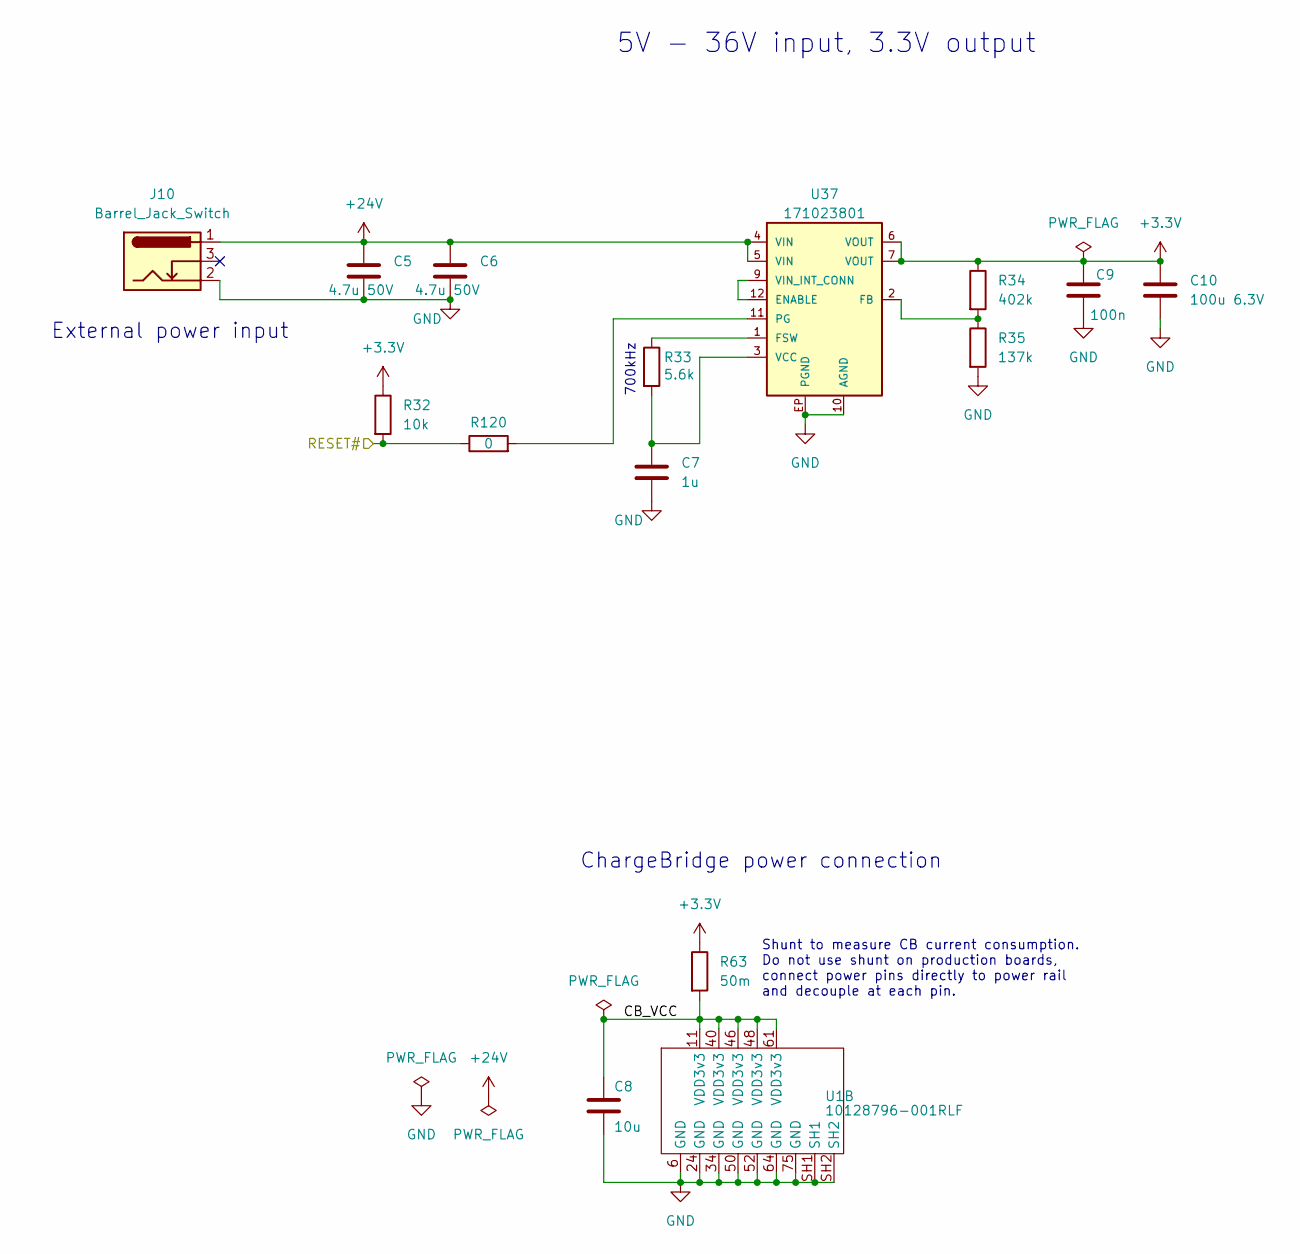
[picture p14: schematic power_supply.kicad_sch, ChargeBridge Eval Board]

Parts:
C5, C6: 4.7u 50V; C_1210_3225Metric; MPN C3225X7R1H475K250AB; Digikey 445-7726-1-ND
C7: 1u; C_0603_1608Metric; MPN C0603C105K3PACTU; Digikey 399-C0603C105K3PACTUCT-ND
C8: 10u; C_0603_1608Metric; MPN GRM188R6YA106MA73J; Digikey 490-GRM188R6YA106MA73JCT-ND
C9: 100n; C_0603_1608Metric; MPN C0603C104K5RACAUTO; Digikey 399-6856-1-ND
C10: 100u 6.3V; C_1206_3216Metric; MPN JMK316ABJ107ML-T; Digikey 587-3395-1-ND
J10: Barrel_Jack_Switch; CUI_PJ-044AH; MPN PJ-044AH; Digikey CP-044AH-ND
R32: 10k; R_0603_1608Metric; MPN RMCF0603FT10K0; Digikey RMCF0603FT10K0CT-ND
R33: 5.6k; R_0603_1608Metric; MPN RMCF0603FT5K60; Digikey RMCF0603FT5K60CT-ND
R34: 402k; R_0603_1608Metric; MPN RMCF0603FT402K
R35: 137k; R_0603_1608Metric; MPN RMCF0603FT137k
R63: 50m; R_1206_3216Metric; MPN CSR1206FT50L0; Digikey CSR1206FT50L0CT-ND
R120: 0; R_0603_1608Metric; MPN RMCF0603ZT0R00; Digikey RMCF0603ZT0R00CT-ND
U1: 10128796-001RLF; AMPHENOL_10128796-001RLF_ChargeBridge_Wurth_standoff; MPN 10128796-001RLF
U37: 171023801; WPME-VDLM_LGA-12EP; MPN 171023801; Digikey 732-171023801CT-ND

Connections:
+3.3V: C9.1, C10.1, R32.1, R34.1, R63.1, U37.6 (VOUT), U37.7 (VOUT); also elsewhere on the board
+24V: C5.1, C6.1, J10.1, U37.4 (VIN), U37.5 (VIN); also elsewhere on the board
/30V > 3.3V Power Supply/CB_VCC: C8.2, R63.2, U1.11 (VDD3v3), U1.40 (VDD3v3), U1.46 (VDD3v3), U1.48 (VDD3v3), U1.61 (VDD3v3)
/30V > 3.3V Power Supply/RESET#: R32.2, R120.1; also elsewhere on the board
GND: C5.2, C6.2, C7.2, C8.1, C9.2, C10.2, J10.2, R35.2, U1.6 (GND), U1.24 (GND), U1.34 (GND), U1.50 (GND), U1.52 (GND), U1.64 (GND), U1.75 (GND), U1.SH1, U1.SH2, U37.10 (AGND), U37.EP (PGND); also elsewhere on the board
unnamed: U37.9 (VIN_INT_CONN), U37.12 (ENABLE)
unnamed: R34.2, R35.1, U37.2 (FB)
unnamed: R33.1, U37.1 (FSW)
unnamed: R120.2, U37.11 (PG)
unnamed: C7.1, R33.2, U37.3 (VCC)

Notes on the sheet:
5V - 36V input, 3.3V output
Shunt to measure CB current consumption. Do not use shunt on production boards, connect power pins directly to power rail and decouple at each pin.
ChargeBridge power connection
External power input
700kHz

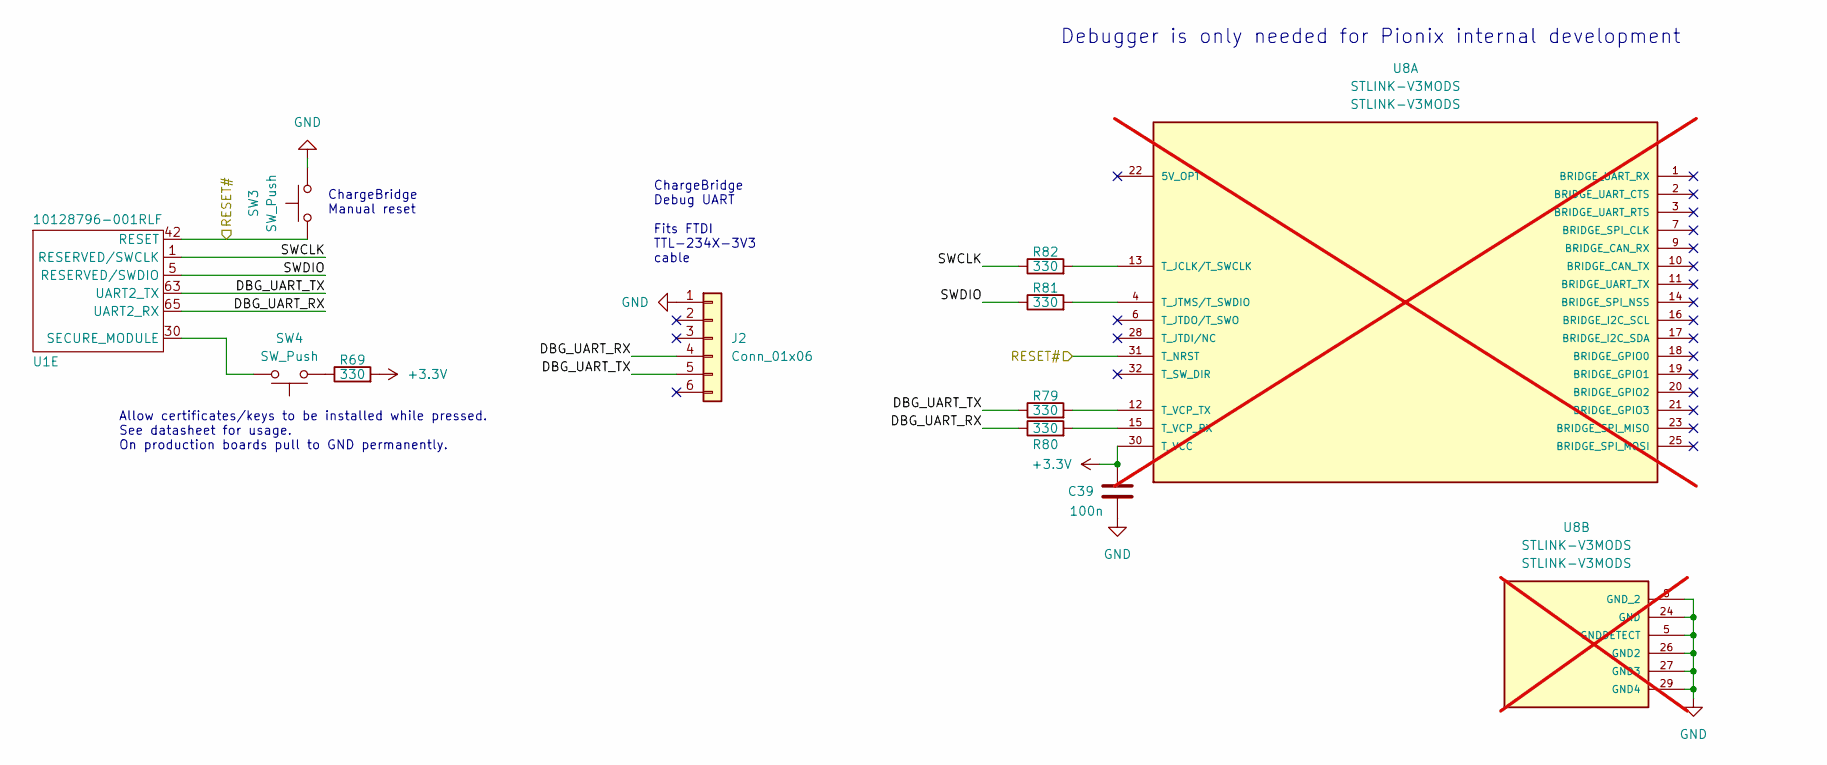
[picture p15: schematic debug.kicad_sch, ChargeBridge Eval Board]

Parts:
C39: 100n; C_0603_1608Metric; MPN C0603C104K5RACAUTO; Digikey 399-6856-1-ND
J2: Conn_01x06; PinHeader_1x06_P2.54mm_Vertical; MPN TS-106-T-A; Digikey SAM1112-06-ND
R69, R79, R80, R81, R82: 330; R_0603_1608Metric; MPN RMCF0603FT330R; Digikey RMCF0603FT330RCT-ND
SW3, SW4: SW_Push; SW_TS02-66-70-BK-160-LCR-D; MPN TS02-66-70-BK-160-LCR-D; Digikey 2223-TS02-66-70-BK-160-LCR-D-ND
U1: 10128796-001RLF; AMPHENOL_10128796-001RLF_ChargeBridge_Wurth_standoff; MPN 10128796-001RLF
U8: STLINK-V3MODS; MODULE_STLINK-V3MODS; PARTREV 1; Digikey 497-STLINK-V3MODS-ND; not fitted

Connections:
+3.3V: C39.1, R69.2, U8.30 (T_VCC); also elsewhere on the board
/30V > 3.3V Power Supply/RESET#: SW3.1, U1.42 (RESET), U8.31 (T_NRST); also elsewhere on the board
/Debugging/DBG_UART_RX: J2.4, R80.1, U1.65 (UART2_RX)
/Debugging/DBG_UART_TX: J2.5, R79.1, U1.63 (UART2_TX)
/Debugging/SWCLK: R82.1, U1.1 (RESERVED/SWCLK)
/Debugging/SWDIO: R81.1, U1.5 (RESERVED/SWDIO)
GND: C39.2, J2.1, SW3.2, U8.5 (GNDDETECT), U8.8 (GND_2), U8.24 (GND), U8.26 (GND2), U8.27 (GND3), U8.29 (GND4); also elsewhere on the board
unnamed: R69.1, SW4.1
unnamed: SW4.2, U1.30 (SECURE_MODULE)
unnamed: R82.2, U8.13 (T_JCLK/T_SWCLK)
unnamed: R81.2, U8.4 (T_JTMS/T_SWDIO)
unnamed: R80.2, U8.15 (T_VCP_RX)
unnamed: R79.2, U8.12 (T_VCP_TX)

Notes on the sheet:
Allow certificates/keys to be installed while pressed. See datasheet for usage. On production boards pull to GND permanently.
Debugger is only needed for Pionix internal development
ChargeBridge Manual reset
ChargeBridge Debug UART Fits FTDI TTL-234X-3V3 cable

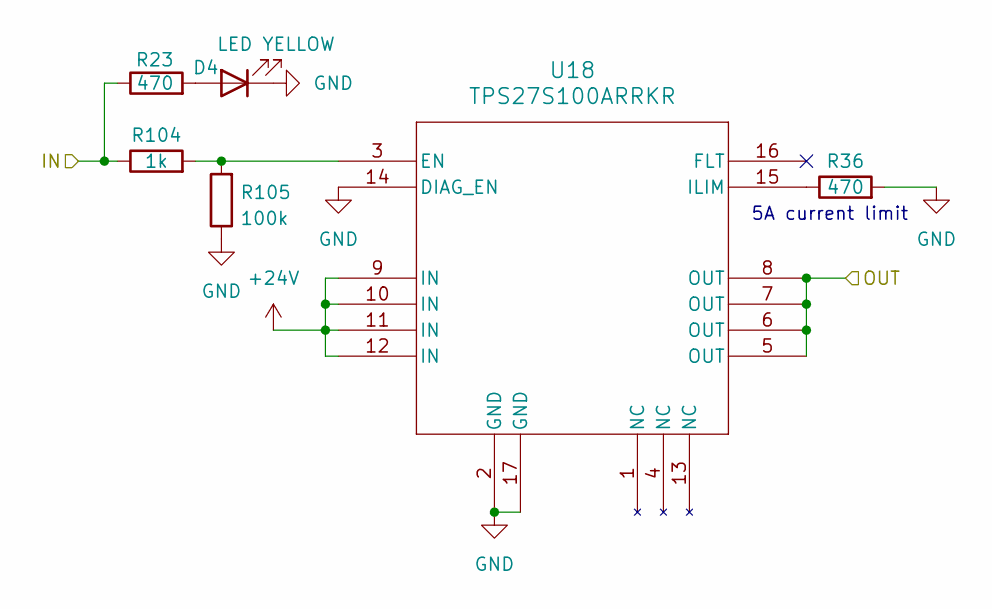
[picture p16: schematic levelshift_output_5A.kicad_sch, ChargeBridge Eval Board]

Parts:
D4: LED YELLOW; LED_0603_1608Metric; MPN 150060AS75000; Digikey 732-150060AS75000CT-ND
R23, R36: 470; R_0603_1608Metric; MPN RMCF0603FT470R; Digikey RMCF0603FT470RCT-ND
R104: 1k; R_0603_1608Metric; MPN RMCF0603FG1K00; Digikey RMCF0603FG1K00CT-ND
R105: 100k; R_0603_1608Metric; MPN RMCF0603FT100K; Digikey RMCF0603FT100KCT-ND
U18: TPS27S100ARRKR; WQFN16_RRK_TEX; MPN TPS27S100ARRKR; Digikey 296-TPS27S100ARRKRCT-ND

Connections:
+24V: U18.9 (IN), U18.10 (IN), U18.11 (IN), U18.12 (IN); also elsewhere on the board
/Relays/LevelShiftOutputOD5/OUT: U18.5 (OUT), U18.6 (OUT), U18.7 (OUT), U18.8 (OUT); also elsewhere on the board
/Relays/RELAY3: R23.1, R104.1; also elsewhere on the board
GND: D4.1 (K), R36.2, R105.1, U18.2 (GND), U18.14 (DIAG_EN), U18.17 (GND); also elsewhere on the board
unnamed: D4.2 (A), R23.2
unnamed: R104.2, R105.2, U18.3 (EN)
unnamed: R36.1, U18.15 (ILIM)

Parts of its further copies:
D5, D6: LED YELLOW; LED_0603_1608Metric; MPN 150060AS75000; Digikey 732-150060AS75000CT-ND
R24, R27, R75, R77: 470; R_0603_1608Metric; MPN RMCF0603FT470R; Digikey RMCF0603FT470RCT-ND
R116, R118: 1k; R_0603_1608Metric; MPN RMCF0603FG1K00; Digikey RMCF0603FG1K00CT-ND
R117, R119: 100k; R_0603_1608Metric; MPN RMCF0603FT100K; Digikey RMCF0603FT100KCT-ND
U19, U20: TPS27S100ARRKR; WQFN16_RRK_TEX; MPN TPS27S100ARRKR; Digikey 296-TPS27S100ARRKRCT-ND

Connections of its further copies:
+24V: U19.9 (IN), U19.10 (IN), U19.11 (IN), U19.12 (IN), U20.9 (IN), U20.10 (IN), U20.11 (IN), U20.12 (IN); also elsewhere on the board
/Relays/LevelShiftOutputOD6/OUT: U19.5 (OUT), U19.6 (OUT), U19.7 (OUT), U19.8 (OUT); also elsewhere on the board
/Relays/LevelShiftOutputOD7/OUT: U20.5 (OUT), U20.6 (OUT), U20.7 (OUT), U20.8 (OUT); also elsewhere on the board
/Relays/RELAY1: R27.1, R118.1; also elsewhere on the board
/Relays/RELAY2: R24.1, R116.1; also elsewhere on the board
GND: D5.1 (K), D6.1 (K), R75.2, R77.2, R117.1, R119.1, U19.2 (GND), U19.14 (DIAG_EN), U19.17 (GND), U20.2 (GND), U20.14 (DIAG_EN), U20.17 (GND); also elsewhere on the board
unnamed: D5.2 (A), R24.2
unnamed: D6.2 (A), R27.2
unnamed: R116.2, R117.2, U19.3 (EN)
unnamed: R75.1, U19.15 (ILIM)
unnamed: R118.2, R119.2, U20.3 (EN)
unnamed: R77.1, U20.15 (ILIM)

Notes on the sheet:
5A current limit

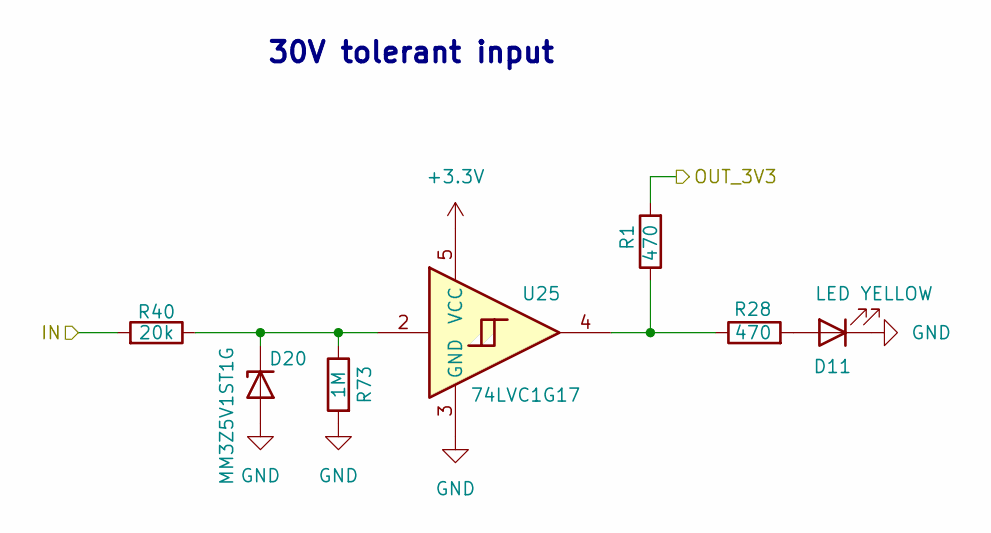
[picture p17: schematic levelshift_input.kicad_sch, ChargeBridge Eval Board]

Parts:
D11: LED YELLOW; LED_0603_1608Metric; MPN 150060AS75000; Digikey 732-150060AS75000CT-ND
D20: MM3Z5V1ST1G; D_SOD-323; MPN MM3Z5V1ST1G; Digikey MM3Z5V1ST1GOSCT-ND
R1, R28: 470; R_0603_1608Metric; MPN RMCF0603FT470R; Digikey RMCF0603FT470RCT-ND
R40: 20k; R_0603_1608Metric; MPN RMCF0603FT20K0; Digikey RMCF0603FT20K0CT-ND
R73: 1M; R_0603_1608Metric; MPN RMCF0603FT1M00; Digikey RMCF0603FT1M00CT-ND
U25: 74LVC1G17; SOT-353_SC-70-5; MPN SN74LVC1G17DCKR; Digikey 296-11934-1-ND

Connections:
+3.3V: U25.5 (VCC); also elsewhere on the board
/Buttons, RGB LED/LevelShiftInput1/OUT_3V3: R1.2; also elsewhere on the board
/Buttons, RGB LED/STOP_CHARGING: R40.2; also elsewhere on the board
GND: D11.1 (K), D20.2 (A), R73.2, U25.3 (GND); also elsewhere on the board
unnamed: D11.2 (A), R28.2
unnamed: D20.1 (K), R40.1, R73.1, U25.2
unnamed: R1.1, R28.1, U25.4

Parts of its further copies:
D12, D17, D18, D19, D21, D23, D25, D27, D29: LED YELLOW; LED_0603_1608Metric; MPN 150060AS75000; Digikey 732-150060AS75000CT-ND
D22, D24, D26, D28, D30, D32, D34, D36, D38: MM3Z5V1ST1G; D_SOD-323; MPN MM3Z5V1ST1G; Digikey MM3Z5V1ST1GOSCT-ND
R2, R3, R7, R19, R20, R21, R22, R37, R38, R39, R41, R42, R44, R45, R47, R48, R59, R61: 470; R_0603_1608Metric; MPN RMCF0603FT470R; Digikey RMCF0603FT470RCT-ND
R43, R46, R49, R52, R55, R68, R71, R74, R99: 20k; R_0603_1608Metric; MPN RMCF0603FT20K0; Digikey RMCF0603FT20K0CT-ND
R76, R78, R94, R95, R96, R97, R98, R102, R103: 1M; R_0603_1608Metric; MPN RMCF0603FT1M00; Digikey RMCF0603FT1M00CT-ND
U26, U27, U28, U29, U30, U31, U32, U33, U34: 74LVC1G17; SOT-353_SC-70-5; MPN SN74LVC1G17DCKR; Digikey 296-11934-1-ND

Connections of its further copies:
+3.3V: U26.5 (VCC), U27.5 (VCC), U28.5 (VCC), U29.5 (VCC), U30.5 (VCC), U31.5 (VCC), U32.5 (VCC), U33.5 (VCC), U34.5 (VCC); also elsewhere on the board
/Buttons, RGB LED/EMERGENCY_SHDN_IN: R43.2; also elsewhere on the board
/Buttons, RGB LED/LevelShiftInput2/OUT_3V3: R2.2; also elsewhere on the board
/GPIO9: R61.2; also elsewhere on the board
/GPIOs/LevelShiftInput3/IN: R46.2; also elsewhere on the board
/GPIOs/LevelShiftInput3/OUT_3V3: R3.2; also elsewhere on the board
/GPIOs/LevelShiftInput4/IN: R49.2; also elsewhere on the board
/GPIOs/LevelShiftInput4/OUT_3V3: R7.2; also elsewhere on the board
/GPIOs/LevelShiftInput5/IN: R52.2; also elsewhere on the board
/GPIOs/LevelShiftInput5/OUT_3V3: R19.2; also elsewhere on the board
/GPIOs/LevelShiftInput6/IN: R55.2; also elsewhere on the board
/GPIOs/LevelShiftInput6/OUT_3V3: R20.2; also elsewhere on the board
/GPIOs/LevelShiftInput10/IN: R99.2; also elsewhere on the board
/Relays/LevelShiftInput7/IN: R68.2; also elsewhere on the board
/Relays/LevelShiftInput8/IN: R71.2; also elsewhere on the board
/Relays/LevelShiftInput9/IN: R74.2; also elsewhere on the board
/Relays/RELAY1_FB: R21.2; also elsewhere on the board
/Relays/RELAY2_FB: R22.2; also elsewhere on the board
/Relays/RELAY3_FB: R59.2; also elsewhere on the board
GND: D12.1 (K), D17.1 (K), D18.1 (K), D19.1 (K), D21.1 (K), D22.2 (A), D23.1 (K), D24.2 (A), D25.1 (K), D26.2 (A), D27.1 (K), D28.2 (A), D29.1 (K), D30.2 (A), D32.2 (A), D34.2 (A), D36.2 (A), D38.2 (A), R76.2, R78.2, R94.2, R95.2, R96.2, R97.2, R98.2, R102.2, R103.2, U26.3 (GND), U27.3 (GND), U28.3 (GND), U29.3 (GND), U30.3 (GND), U31.3 (GND), U32.3 (GND), U33.3 (GND), U34.3 (GND); also elsewhere on the board
unnamed: D12.2 (A), R37.2
unnamed: D17.2 (A), R38.2
unnamed: D18.2 (A), R39.2
unnamed: D19.2 (A), R41.2
unnamed: D21.2 (A), R42.2
unnamed: D22.1 (K), R43.1, R76.1, U26.2
unnamed: D23.2 (A), R44.2
unnamed: D24.1 (K), R46.1, R78.1, U27.2
unnamed: D25.2 (A), R45.2
unnamed: D26.1 (K), R49.1, R94.1, U28.2
unnamed: D27.2 (A), R47.2
unnamed: D28.1 (K), R52.1, R95.1, U29.2
unnamed: D29.2 (A), R48.2
unnamed: D30.1 (K), R55.1, R96.1, U30.2
unnamed: D32.1 (K), R68.1, R97.1, U31.2
unnamed: D34.1 (K), R71.1, R98.1, U32.2
unnamed: D36.1 (K), R74.1, R102.1, U33.2
unnamed: D38.1 (K), R99.1, R103.1, U34.2
unnamed: R2.1, R37.1, U26.4
unnamed: R3.1, R38.1, U27.4
unnamed: R19.1, R41.1, U29.4
unnamed: R20.1, R42.1, U30.4
unnamed: R21.1, R44.1, U31.4
unnamed: R22.1, R45.1, U32.4
unnamed: R7.1, R39.1, U28.4
unnamed: R47.1, R59.1, U33.4
unnamed: R48.1, R61.1, U34.4

Notes on the sheet:
30V tolerant input

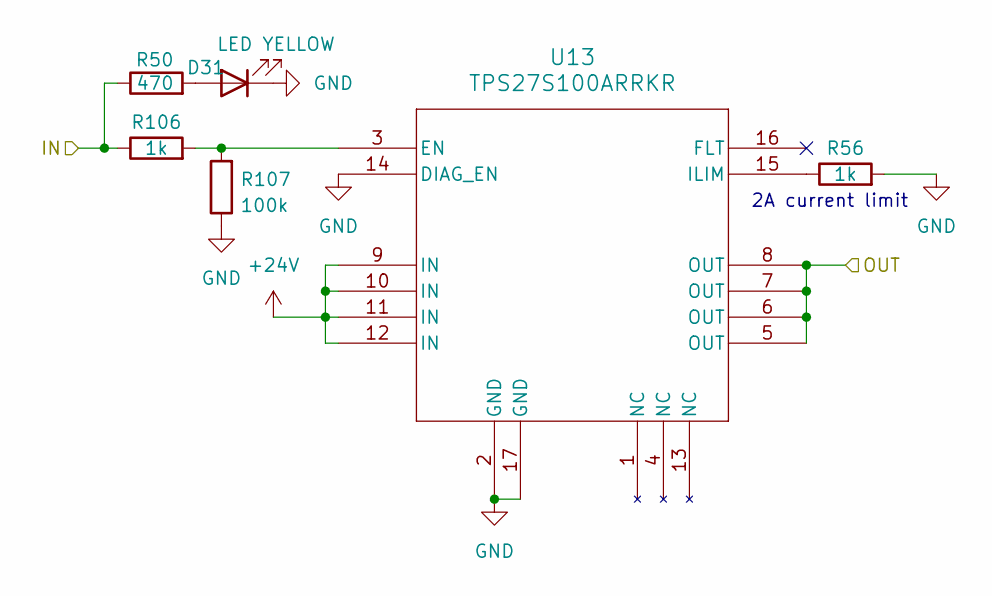
[picture p18: schematic levelshift_output_2A.kicad_sch, ChargeBridge Eval Board]

Parts:
D31: LED YELLOW; LED_0603_1608Metric; MPN 150060AS75000; Digikey 732-150060AS75000CT-ND
R50: 470; R_0603_1608Metric; MPN RMCF0603FT470R; Digikey RMCF0603FT470RCT-ND
R56, R106: 1k; R_0603_1608Metric; MPN RMCF0603FG1K00; Digikey RMCF0603FG1K00CT-ND
R107: 100k; R_0603_1608Metric; MPN RMCF0603FT100K; Digikey RMCF0603FT100KCT-ND
U13: TPS27S100ARRKR; WQFN16_RRK_TEX; MPN TPS27S100ARRKR; Digikey 296-TPS27S100ARRKRCT-ND

Connections:
+24V: U13.9 (IN), U13.10 (IN), U13.11 (IN), U13.12 (IN); also elsewhere on the board
/GPIOs/LevelShiftOutputOD/IN: R50.1, R106.1; also elsewhere on the board
/GPIOs/LevelShiftOutputOD/OUT: U13.5 (OUT), U13.6 (OUT), U13.7 (OUT), U13.8 (OUT); also elsewhere on the board
GND: D31.1 (K), R56.2, R107.1, U13.2 (GND), U13.14 (DIAG_EN), U13.17 (GND); also elsewhere on the board
unnamed: D31.2 (A), R50.2
unnamed: R106.2, R107.2, U13.3 (EN)
unnamed: R56.1, U13.15 (ILIM)

Parts of its further copies:
D1, D33, D35, D37, D39: LED YELLOW; LED_0603_1608Metric; MPN 150060AS75000; Digikey 732-150060AS75000CT-ND
R31, R51, R53, R54, R57: 470; R_0603_1608Metric; MPN RMCF0603FT470R; Digikey RMCF0603FT470RCT-ND
R58, R60, R62, R64, R65, R67, R108, R110, R112, R114: 1k; R_0603_1608Metric; MPN RMCF0603FG1K00; Digikey RMCF0603FG1K00CT-ND
R66, R109, R111, R113, R115: 100k; R_0603_1608Metric; MPN RMCF0603FT100K; Digikey RMCF0603FT100KCT-ND
U14, U15, U16, U17, U21: TPS27S100ARRKR; WQFN16_RRK_TEX; MPN TPS27S100ARRKR; Digikey 296-TPS27S100ARRKRCT-ND

Connections of its further copies:
+24V: U14.9 (IN), U14.10 (IN), U14.11 (IN), U14.12 (IN), U15.9 (IN), U15.10 (IN), U15.11 (IN), U15.12 (IN), U16.9 (IN), U16.10 (IN), U16.11 (IN), U16.12 (IN), U17.9 (IN), U17.10 (IN), U17.11 (IN), U17.12 (IN), U21.9 (IN), U21.10 (IN), U21.11 (IN), U21.12 (IN); also elsewhere on the board
/Buttons, RGB LED/EMERGENCY_SHDN_OUT: U21.5 (OUT), U21.6 (OUT), U21.7 (OUT), U21.8 (OUT); also elsewhere on the board
/Buttons, RGB LED/LevelShiftOutputOD3/IN: R31.1, R65.1; also elsewhere on the board
/GPIOs/LevelShiftOutputOD1/IN: R51.1, R108.1; also elsewhere on the board
/GPIOs/LevelShiftOutputOD1/OUT: U14.5 (OUT), U14.6 (OUT), U14.7 (OUT), U14.8 (OUT); also elsewhere on the board
/GPIOs/LevelShiftOutputOD2/IN: R53.1, R110.1; also elsewhere on the board
/GPIOs/LevelShiftOutputOD2/OUT: U15.5 (OUT), U15.6 (OUT), U15.7 (OUT), U15.8 (OUT); also elsewhere on the board
/GPIOs/LevelShiftOutputOD3/IN: R54.1, R112.1; also elsewhere on the board
/GPIOs/LevelShiftOutputOD3/OUT: U16.5 (OUT), U16.6 (OUT), U16.7 (OUT), U16.8 (OUT); also elsewhere on the board
/GPIOs/LevelShiftOutputOD4/IN: R57.1, R114.1; also elsewhere on the board
/GPIOs/LevelShiftOutputOD4/OUT: U17.5 (OUT), U17.6 (OUT), U17.7 (OUT), U17.8 (OUT); also elsewhere on the board
GND: D1.1 (K), D33.1 (K), D35.1 (K), D37.1 (K), D39.1 (K), R58.2, R60.2, R62.2, R64.2, R66.1, R67.2, R109.1, R111.1, R113.1, R115.1, U14.2 (GND), U14.14 (DIAG_EN), U14.17 (GND), U15.2 (GND), U15.14 (DIAG_EN), U15.17 (GND), U16.2 (GND), U16.14 (DIAG_EN), U16.17 (GND), U17.2 (GND), U17.14 (DIAG_EN), U17.17 (GND), U21.2 (GND), U21.14 (DIAG_EN), U21.17 (GND); also elsewhere on the board
unnamed: D1.2 (A), R31.2
unnamed: D33.2 (A), R51.2
unnamed: D35.2 (A), R53.2
unnamed: D37.2 (A), R54.2
unnamed: D39.2 (A), R57.2
unnamed: R108.2, R109.2, U14.3 (EN)
unnamed: R58.1, U14.15 (ILIM)
unnamed: R110.2, R111.2, U15.3 (EN)
unnamed: R60.1, U15.15 (ILIM)
unnamed: R112.2, R113.2, U16.3 (EN)
unnamed: R62.1, U16.15 (ILIM)
unnamed: R114.2, R115.2, U17.3 (EN)
unnamed: R64.1, U17.15 (ILIM)
unnamed: R65.2, R66.2, U21.3 (EN)
unnamed: R67.1, U21.15 (ILIM)

Notes on the sheet:
2A current limit

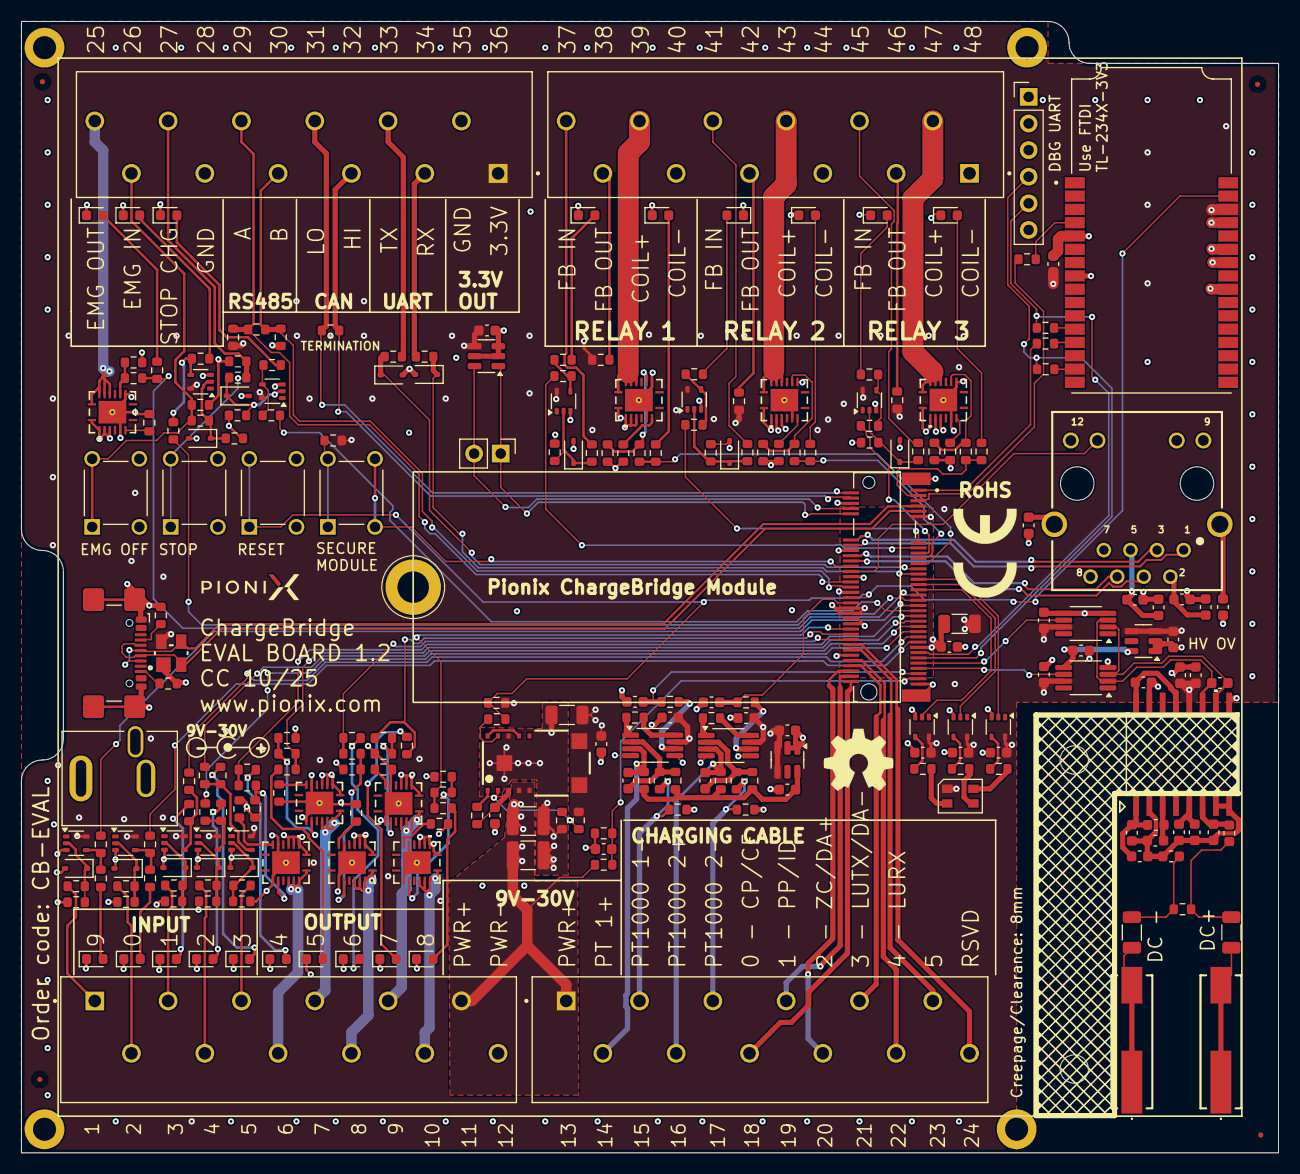
[picture p19: board cb-eval-board.kicad_pcb from above]

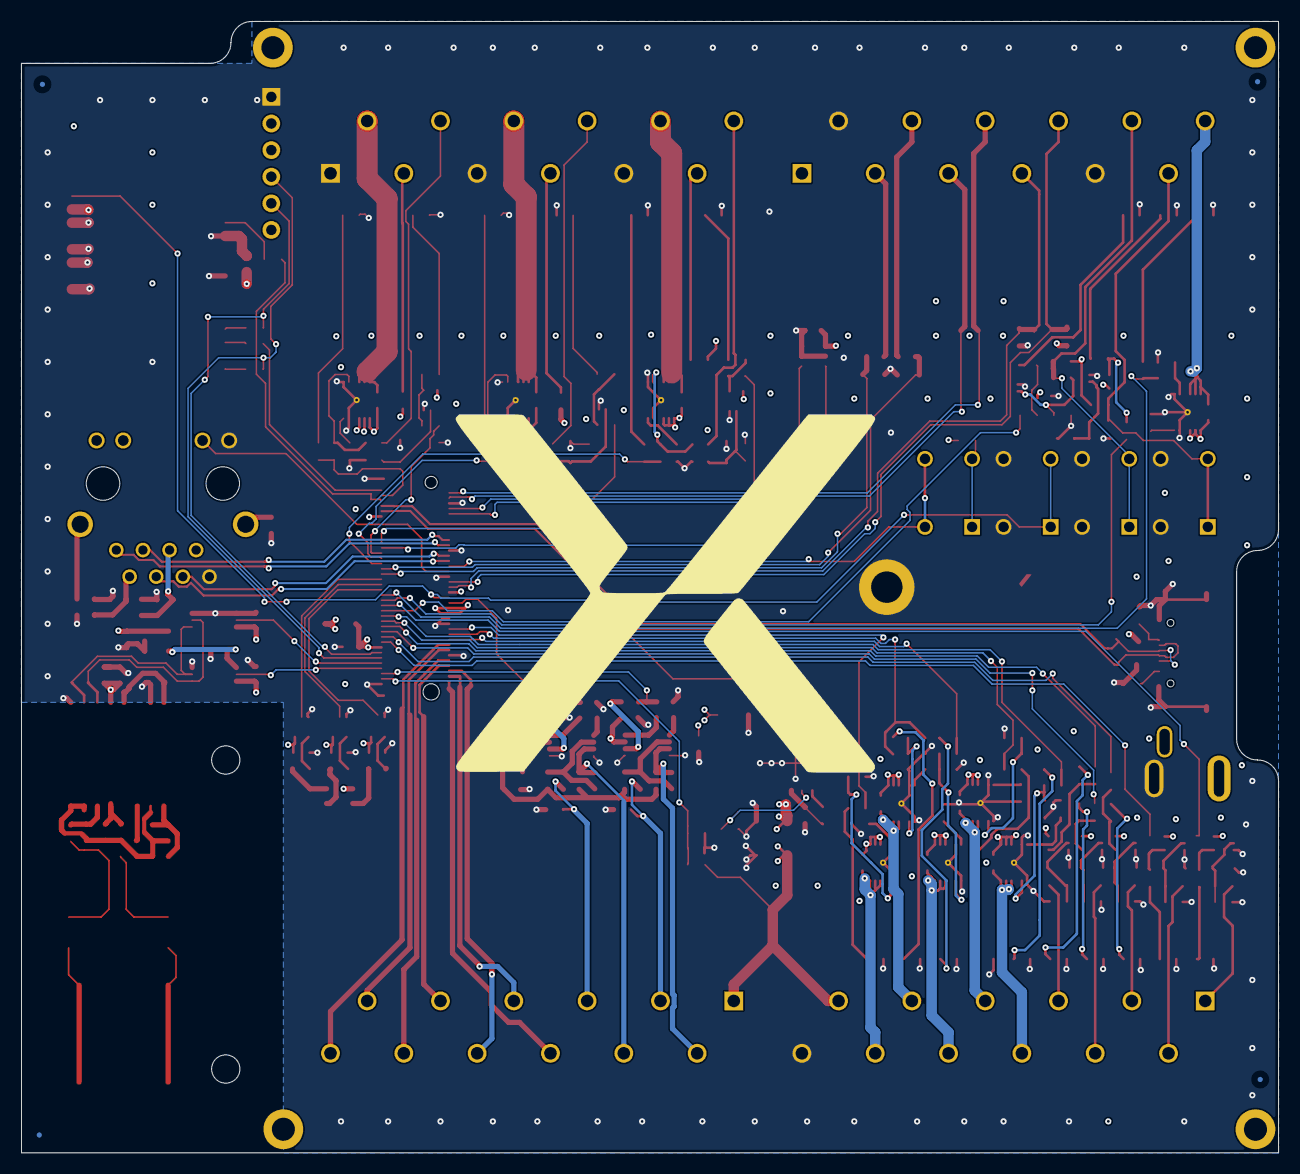
[picture p20: board cb-eval-board.kicad_pcb from below]

Board: 4 copper layers, 120.0 x 108.0 mm, 264 parts (5 on the bottom side), 188 nets.
