parkourlrc/pcb-PionixPublic--cb-eval-board-5fd87b56d0/(notices)

Notices in the files:
cb-eval-board/levelshift_input.kicad_sch:
License: CERN-OHL-P
